ciupakt/caliper/README.md

# Caliper — bezprzewodowy system pomiarowy (ESP32 + suwmiarka)

Projekt **Caliper** to zaawansowany system bezprzewodowego pomiaru długości oparty na platformie ESP32, cyfrowej suwmiarce (odczyt strumienia bitów), akcelerometrze IIS328DQ oraz sterowniku silnika STSPIN250. Dane są przesyłane dwukierunkowo przez protokół **ESP-NOW**, a sterowanie odbywa się przez:

- **Web UI** hostowane przez ESP32 Master (WiFi AP + HTTP + LittleFS)
- **Desktop GUI** w Pythonie (Dear PyGui) komunikujące się z Master po **Serial**
- **Serial CLI** - interfejs wiersza poleceń przez port szeregowy
- **RC (Pilot)** - bezprzewodowy pilot z dwoma przyciskami (ESP-NOW → Master)

## 📑 Spis treści

- [Funkcjonalności](#funkcjonalności)
- [Architektura systemu](#architektura-systemu)
- [Wymagania](#wymagania)
- [Szybki start](#szybki-start)
- [Instalacja i konfiguracja](#instalacja-i-konfiguracja)
- [Użytkowanie](#użytkowanie)
- [Dokumentacja API](#dokumentacja-api)
- [Struktura projektu](#struktura-projektu)
- [Konfiguracja](#konfiguracja)
- [Rozwiązywanie problemów](#rozwiązywanie-problemów)
- [Współpraca](#współpraca)
- [Licencja](#licencja)

## ✨ Funkcjonalności

### Pomiar i sensory
- **Pomiar z cyfrowej suwmiarki** - dekodowanie danych z interfejsu CLK/DATA/TRIG
- **Walidacja zakresów** - automatyczna walidacja pomiarów (-1000.0 do 1000.0 mm)
- **Odczyt kąta z IIS328DQ** - akcelerometr I2C do pomiaru pochylenia
- **Pomiar napięcia baterii** - monitorowanie stanu baterii przez ADC

### Sterowanie silnikiem
- **Sterowanie silnikiem DC** przez sterownik STSPIN250
- **PWM + PH + REF + EN + FAULT** - pełna kontrola 5-pinowa z detekcją błędów
- **Automatyzacja pomiarów** - silnik uruchamiany automatycznie przy pomiarze

### Komunikacja
- **ESP-NOW** - dwukierunkowa komunikacja bezprzewodowa Master↔Slave
- **ESP-NOW RC→Master** - pilot RC wysyła komendy TRIG_MEAS / DROP_MEAS
- **HTTP API** - REST API dla Web UI
- **Serial CLI** - interfejs wiersza poleceń dla diagnostyki i konfiguracji
- **Retry mechanism** - automatyczne ponawianie wysyłek przy błędach

### Interfejsy użytkownika
- **Web UI** - responsywny interfejs HTML/CSS/JS hostowany na ESP32
- **Python GUI** - aplikacja desktopowa z Dear PyGui
  - Wykresy pomiarów w czasie rzeczywistym
  - Eksport danych do CSV
  - Logi systemowe
  - Kalibracja i konfiguracja

### Przechowywanie danych
- **Persistent Storage** - ustawienia zapisywane w NVS (Preferences)
- **Nazwy sesji pomiarowych** - organizacja pomiarów
- **Offset kalibracji** - trwałe przechowywanie wartości kalibracji
- **MeasurementState** - klasa zarządzająca stanem pomiarowym z buforami tekstowymi
- **PreferencesManager** - menedżer ustawień z walidacją i trwałym przechowywaniem

### System obsługi błędów
- **Kompleksowy system kodów błędów** - 8 kategorii (Communication, Sensor, Motor, Power, Storage, Network, Validation, System)
- **Makra logowania** - LOG_ERROR, LOG_WARNING z automatycznym dekodowaniem kategorii i modułu
- **ErrorHandler** - singleton do śledzenia statystyk błędów
- **Funkcje pomocnicze ESP-NOW** - espnow_send_with_retry, espnow_add_peer_with_retry

## 🏗️ Architektura systemu

### Komponenty systemu

```mermaid
flowchart TD
    %% Master pracuje równolegle: WiFi AP/HTTP + ESP-NOW, najczęściej WIFI_AP_STA.

    subgraph SYS[System Caliper]
        subgraph M[ESP32 Master<br/>caliper_master]
            M_HTTP[HTTP server :80]
            M_FS[LittleFS<br/>UI web: index.html/style.css/app.js]
            M_ESPNOW[ESP-NOW manager<br/>TX/RX MessageMaster/MessageSlave]
            M_SERIAL[Serial CLI<br/>komendy ASCII -> msgMaster]
            M_PREFS[Preferences Manager<br/>NVS storage]
            M_STATE[MeasurementState<br/>stan pomiarowy]
            M_ERROR[ErrorHandler<br/>statystyki błędów]
        end

        subgraph S[ESP32 Slave<br/>caliper_slave]
            S_ESPNOW[ESP-NOW<br/>RX komend / TX danych]
            S_CAL[Suwmiarka<br/>odczyt i dekoder]
            S_ACC[IIS328DQ<br/>I2C]
            S_BATT[Bateria<br/>ADC]
            S_MOTOR[Silnik<br/>STSPIN250]
        end

        subgraph SHARED[CaliperShared]
            SH_ERROR[ErrorCodes<br/>8 kategorii]
            SH_HELPER[ESP-NOW Helper<br/>retry mechanism]
        end

        subgraph RC[ESP32-C3 RC<br/>caliper_rc]
            RC_ESPNOW[ESP-NOW<br/>TX MessageRC]
            RC_BTN1[Przycisk TRIG<br/>GPIO8]
            RC_BTN2[Przycisk DROP<br/>GPIO9]
            RC_LED[LED<br/>feedback]
        end

        WEB[Przeglądarka<br/>Web UI]
        GUI[Python GUI<br/>Dear PyGui]
    end

    WEB <--> |HTTP| M_HTTP
    M_HTTP --> M_FS
    GUI <--> |USB Serial| M_SERIAL

    M_ESPNOW <--> |ESP-NOW| S_ESPNOW
    RC_ESPNOW --> |ESP-NOW<br/>CMD_TRIG_MEAS / CMD_DROP_MEAS| M_ESPNOW
    RC_BTN1 --> RC_ESPNOW
    RC_BTN2 --> RC_ESPNOW
    RC_ESPNOW --> RC_LED
    S_CAL --> S_ESPNOW
    S_ACC --> S_ESPNOW
    S_BATT --> S_ESPNOW
    S_MOTOR <--> S_ESPNOW

    M_SERIAL --> M_STATE
    M_PREFS --> M_STATE
    M_HTTP --> M_STATE
    M_ESPNOW --> M_STATE
    M_ERROR --> M_STATE
    
    M_ESPNOW -.-> |używa| SH_HELPER
    M_ERROR -.-> |używa| SH_ERROR
    S_ESPNOW -.-> |używa| SH_HELPER
```

### Przepływ pomiaru (typowy)

```mermaid
sequenceDiagram
    participant U as Użytkownik
    participant GUI as GUI przez Serial
    participant WEB as Web UI przez HTTP
    participant RC as RC Pilot
    participant M as ESP32 Master
    participant EH as ErrorHandler
    participant MS as MeasurementState
    participant PM as PreferencesManager
    participant S as ESP32 Slave
    participant CAL as Suwmiarka
    participant ACC as IIS328DQ
    participant BAT as Bateria

    alt Sterowanie z GUI
        U->>GUI: „Pomiar" (m)
        GUI->>M: Serial: m + LF
    else Sterowanie z Web UI
        U->>WEB: klik „Wykonaj pomiar"
        WEB->>M: HTTP /measure albo /measure_session
    else Sterowanie z RC
        U->>RC: przycisk TRIG_MEAS
        RC->>M: ESP-NOW: MessageRC{CMD_TRIG_MEAS}
    end

    M->>PM: loadSettings()
    PM-->>M: systemStatus (offset, motorSpeed, etc.)
    
    M->>MS: setMeasurementInProgress(true)
    M->>S: ESP-NOW: MessageMaster{CMD_MEASURE,...}
    
    alt Błąd ESP-NOW
        S-->>M: ESP-NOW: błąd
        M->>EH: recordError(ERR_ESPNOW_SEND_FAILED)
        EH->>M: LOG_ERROR
        M->>MS: setMeasurementInProgress(false)
    else Sukces
        S->>CAL: odczyt danych CLK/DATA + dekodowanie
        S->>ACC: odczyt kąta przez I2C
        S->>BAT: ADC read
        S-->>M: ESP-NOW: MessageSlave{measurement, angleZ, batteryVoltage}
        
        M->>MS: setMeasurement(measurement + offset)
        M->>MS: setReady(true)
        M->>MS: setMeasurementInProgress(false)
        
        M-->>GUI: Serial log/plot, wartości i offset
        M-->>WEB: JSON, raw i corrected
    end
```

### Połączenia hardware

```mermaid
flowchart LR
    %% Układ: urządzenia po lewej, ESP32 po środku, obciążenia po prawej.

    subgraph CAL[Cyfrowa suwmiarka]
        CAL_CLK[CLK]
        CAL_DATA[DATA]
        CAL_TRIG[TRIG]
    end

    subgraph ACC[IIS328DQ]
        ACC_I2C[I2C]
    end

    subgraph BATT[Bateria]
        BATT_V[Vbat]
    end

subgraph SL[ESP32 Slave]
         GPIO11[GPIO11<br/>CALIPER_CLOCK]
         GPIO12[GPIO12<br/>CALIPER_DATA]
         GPIO13[GPIO13<br/>CALIPER_TRIG]

         GPIO21[GPIO21<br/>I2C SDA]
         GPIO22[GPIO22<br/>I2C SCL]

         GPIO10[GPIO10<br/>BATTERY_ADC]

         GPIO6[GPIO6<br/>MOTOR_PWM]
         GPIO15[GPIO15<br/>MOTOR_PH]
         GPIO7[GPIO7<br/>MOTOR_REF]
         GPIO16[GPIO16<br/>MOTOR_EN]
         GPIO17[GPIO17<br/>MOTOR_FAULT]
     end

     subgraph DRV[STSPIN250]
         DRV_PWM[PWM]
         DRV_PH[PH]
         DRV_REF[REF]
         DRV_EN[EN]
         DRV_FAULT[FAULT]
         DRV_OUT1[OUT1]
         DRV_OUT2[OUT2]
     end

     subgraph MOT[Silnik DC]
         MOT_A[Motor +]
         MOT_B[Motor -]
     end

     CAL_CLK -->|CLK| GPIO11
     CAL_DATA -->|DATA| GPIO12
     GPIO13 -->|TRIG| CAL_TRIG

     GPIO21 <--> |SDA| ACC_I2C
     GPIO22 <--> |SCL| ACC_I2C

     BATT_V -->|ADC| GPIO10

     GPIO6 -->|PWM| DRV_PWM
     GPIO15 -->|PH| DRV_PH
     GPIO7 -->|REF| DRV_REF
     GPIO16 -->|EN| DRV_EN
     GPIO17 -->|FAULT| DRV_FAULT
     DRV_OUT1 --> MOT_A
     DRV_OUT2 --> MOT_B
```

## 📋 Wymagania

### Wymagania sprzętowe
- **1× ESP32-S3 DevKitC** — Slave (suwmiarka + akcelerometr + silnik)
- **1× ESP32-C3 Super Mini** — Master (AP WiFi + HTTP + ESP-NOW)
- **1× ESP32-C3 Super Mini** — RC Pilot (bezprzewodowy pilot)
   - Mikrokontroler: ESP32-C3 160MHz, 320KB RAM, 4MB Flash
- **Cyfrowa suwmiarka** z interfejsem CLK/DATA/TRIG
- **Akcelerometr IIS328DQ** (I2C)
- **Sterownik silnika STSPIN250**
- **Silnik DC**
- **Bateria** z obwodem pomiaru napięcia
- **Kable połączeniowe** zgodnie z diagramem hardware

### Wymagania programowe
- **PlatformIO** - do kompilacji firmware ESP32
   - Ścieżka do skryptów (Windows): `C:\Users\tiim\.platformio\penv\Scripts`
   - Alternatywnie: `pio` w PATH (po instalacji `pip install platformio`)
- **Python 3.x** - do uruchomienia GUI
- **Visual Studio Code** (zalecane) z rozszerzeniem PlatformIO

#### Kompilacja na Linux/macOS
```bash
# Slave
cd caliper_slave
pio run --environment caliper_slave

# Master
cd ../caliper_master
pio run --environment caliper_master

# RC
cd ../caliper_rc
pio run --environment caliper_rc
```

#### Wgrywanie firmware na Linux/macOS
```bash
# Slave (port np. /dev/ttyUSB0)
cd caliper_slave
pio run --target upload --environment caliper_slave --upload-port /dev/ttyUSB0

# Master (port np. /dev/ttyUSB0)
cd ../caliper_master
pio run --target upload --environment caliper_master --upload-port /dev/ttyUSB0

# RC (port np. /dev/ttyUSB0)
cd ../caliper_rc
pio run --target upload --environment caliper_rc --upload-port /dev/ttyUSB0
```

#### Wgrywanie Web UI (LittleFS)
```bash
# Linux/macOS
cd caliper_master
pio run --target uploadfs --environment caliper_master --upload-port /dev/ttyUSB0
```

### Zależności Python
Zobacz [`caliper_master_gui/requirements.txt`](caliper_master_gui/requirements.txt:1):
```
dearpygui>=1.9.0
pyserial>=3.5
```

## 🚀 Szybki start

### 1. Klonowanie repozytorium
```bash
git clone <repository-url>
cd caliper
```

### 2. Instalacja zależności Python
```powershell
cd caliper_master_gui
python -m pip install -r requirements.txt
```

### 3. Kompilacja firmware
```powershell
# Slave
cd caliper_slave
C:\Users\tiim\.platformio\penv\Scripts\platformio.exe run --environment caliper_slave

# Master
cd ..\caliper_master
C:\Users\tiim\.platformio\penv\Scripts\platformio.exe run --environment caliper_master

# RC (pilot)
cd ..\caliper_rc
C:\Users\tiim\.platformio\penv\Scripts\platformio.exe run --environment caliper_rc
```

### 4. Wgrywanie firmware
```powershell
# Slave (COM8)
cd caliper_slave
C:\Users\tiim\.platformio\penv\Scripts\platformio.exe run --target upload -s --environment caliper_slave --upload-port COM8

# Master (COM7)
cd ..\caliper_master
C:\Users\tiim\.platformio\penv\Scripts\platformio.exe run --target upload -s --environment caliper_master --upload-port COM7

# RC (COM9)
cd ..\caliper_rc
C:\Users\tiim\.platformio\penv\Scripts\platformio.exe run --target upload -s --environment caliper_rc --upload-port COM9
```

### 5. Wgrywanie Web UI (LittleFS)
```powershell
cd caliper_master
C:\Users\tiim\.platformio\penv\Scripts\platformio.exe run --target uploadfs -s --environment caliper_master --upload-port COM7
```

### 6. Uruchomienie GUI```powershell
cd caliper_master_gui
python caliper_master_gui.py
```

### 7. Użycie Web UI
1. Połącz się z WiFi: `TKK_DBMS` (hasło: `1670$2026`)
2. Otwórz w przeglądarce: `http://192.168.4.1`

## ⚙️ Instalacja i konfiguracja

### Instalacja PlatformIO

#### Windows
1. Zainstaluj [Visual Studio Code](https://code.visualstudio.com/)
2. Zainstaluj rozszerzenie [PlatformIO](https://marketplace.visualstudio.com/items?itemName=platformio.platformio-ide)
3. Alternatywnie: zainstaluj PlatformIO CLI:
   ```powershell
   pip install platformio
   ```

### Konfiguracja portów COM

Domyślne porty są zdefiniowane w plikach `platformio.ini`:
- **Master**: `COM7` ([`caliper_master/platformio.ini`](caliper_master/platformio.ini:1))
- **Slave**: `COM8` ([`caliper_slave/platformio.ini`](caliper_slave/platformio.ini:1))

Aby zmienić port, dodaj `--upload-port COMx` do komendy upload.

### Konfiguracja adresów MAC

Adresy MAC są zdefiniowane w plikach konfiguracyjnych:

**Master** ([`caliper_master/src/config.h`](caliper_master/src/config.h:28)):
```cpp
#define SLAVE_MAC_ADDR {0x10, 0xB4, 0x1D, 0xD6, 0x40, 0xAC}
#define RC_MAC_ADDR {0x00, 0x00, 0x00, 0x00, 0x00, 0x00}  // Uzupełnij po odczycie z RC
```

**Slave** ([`caliper_slave/src/config.h`](caliper_slave/src/config.h:29)):
```cpp
#define MASTER_MAC_ADDR {0x0C, 0x4E, 0xA0, 0x6F, 0x66, 0xD0}
```

**RC** ([`caliper_rc/src/config.h`](caliper_rc/src/config.h)):
```cpp
#define MASTER_MAC_ADDR {0x10, 0xB4, 0x1D, 0xD6, 0x40, 0xBB}
```

Aby znaleźć adres MAC urządzenia, uruchom firmware i sprawdź wyjście Serial przy starcie.

### Konfiguracja WiFi

WiFi AP jest konfigurowane w [`caliper_master/src/config.h`](caliper_master/src/config.h:35):
```cpp
#define WIFI_SSID "TKK_DBMS"
#define WIFI_PASSWORD "1670$2026"
#define WIFI_AP_IP IPAddress(192, 168, 4, 1)
```

## 📖 Użytkowanie

### Web UI

#### Menu główne
1. **Kalibracja** - ustawianie offsetu kalibracji
2. **Nowa sesja pomiarowa** - tworzenie nowej sesji

#### Kalibracja
1. Wprowadź referencję (Reference, mm: -999.999..999.999) — pole automatycznie synchronizuje referencję z urządzeniem
2. Kliknij "Calibrate" — wykonuje pomiar i ustawia offset = surowy pomiar (corrected = reference)
3. Wynik pokazuje: Raw, Offset (applied), Reference, Corrected

#### Sesja pomiarowa
1. Utwórz sesję przez podanie nazwy
2. Kliknij "Wykonaj pomiar" - wykona pomiar z uruchomieniem silnika
3. Wynik pokaże:
   - Pomiar skorygowany (raw - offset)
   - Pomiar surowy
   - Offset
   - Napięcie baterii
   - Odchylenie od pionu (angleZ)

### Python GUI

#### Zakładka "Pomiary"
- **Wykres** - wizualizacja pomiarów w czasie rzeczywistym
- **Historia** - lista ostatnich pomiarów
- **Eksport CSV** - zapis pomiarów do pliku
- **Hotkey 'p'** - szybkie wykonanie pomiaru

#### Zakładka "Kalibracja"
- **Offset kalibracji** - ustawianie i wyświetlanie offsetu
- **Konfiguracja silnika** - prędkość, moment, stan, timeout
- **Logi aplikacji** - komunikaty systemowe
- **Logi szeregowe** - komunikacja z Masterem

### Serial CLI

Podłącz Master przez USB Serial i użyj terminala (np. PuTTY, Arduino Serial Monitor) z ustawieniami:
- Baud rate: 115200
- Data bits: 8
- Parity: None
- Stop bits: 1

#### Dostępne komendy

| Komenda | Opis |
|---|---|
| `m` | Wykonaj pomiar |
| `u` | Zaktualizuj status |
| `t` | Test silnika |
| `o <wartość>` | Ustaw offset kalibracji (-999.999..999.999) |
| `q <wartość>` | Ustaw timeout (ms, 0..600000) |
| `s <wartość>` | Ustaw prędkość silnika (0..255) |
| `r <wartość>` | Ustaw moment silnika (0..255) |
| `n <nazwa>` | Ustaw nazwę sesji (maks 31 znaków) |
| `h` | Pomoc |
| `d` | Wyświetl stan systemu |

### RC Pilot (caliper_rc)

Pilot bezprzewodowy z dwoma przyciskami komunikujący się z Masterem przez ESP-NOW.

#### Przyciski
| Przycisk | Pin | Komenda ESP-NOW | Efekt |
|---|-----|---|---|
| TRIG | GPIO8 | `CMD_TRIG_MEAS` ('R') | Wyzwala pomiar (jak komenda "m") |
| DROP | GPIO9 | `CMD_DROP_MEAS` ('D') | Usuwa ostatni pomiar z GUI + CSV |

#### Komunikacja
- RC → Master: struktura `MessageRC` (1 pole: `CommandType command`)
- Master rozpoznaje pakiety RC po rozmiarze `sizeof(MessageRC)` vs `sizeof(MessageSlave)`
- LED na płytce miga krótko przy wysłaniu komendy (100 ms)

#### Konfiguracja
1. Odczytaj MAC adres RC z Serial output przy starcie
2. Wpisz MAC do `RC_MAC_ADDR` w [`caliper_master/src/config.h`](caliper_master/src/config.h)
3. Wpisz MAC Mastera do `MASTER_MAC_ADDR` w [`caliper_rc/src/config.h`](caliper_rc/src/config.h)
4. Skompiluj i wgraj oba firmware

## 🔌 Dokumentacja API

### HTTP API

#### Endpointy pomiaru

**POST /measure**
Wyzwala pojedynczy pomiar.
```http
POST /measure HTTP/1.1
```
**Odpowiedź:**
```
Pomiar wyzwolony
```

**POST /measure_session**
Wyzwala pomiar w ramach aktywnej sesji.
```http
POST /measure_session HTTP/1.1
```
**Odpowiedź (JSON):**
```json
{
  "sessionName": "moja_sesja",
  "measurementRaw": 12.345,
  "calibrationOffset": 0.000,
  "measurementCorrected": 12.345,
  "valid": true,
  "batteryVoltage": 3.7,
  "angleZ": 5
}
```

#### Endpointy kalibracji

**POST /api/calibration/measure**
Wykonuje pomiar i zwraca surową wartość.
```http
POST /api/calibration/measure HTTP/1.1
```
**Odpowiedź (JSON):**
```json
{
  "success": true,
  "measurementRaw": 12.345,
  "calibrationOffset": 0.000
}
```

**POST /api/calibration/offset**
Ustawia offset kalibracji.
```http
POST /api/calibration/offset?offset=1.234 HTTP/1.1
```
**Odpowiedź (JSON):**
```json
{
  "success": true,
  "calibrationOffset": 1.234
}
```

**POST /api/calibrate**
Jednorazowa kalibracja atomowa (jak przycisk "Calibrate" w GUI): ustawia referencję, wykonuje pomiar i ustawia `calibrationOffset = surowy pomiar`. `corrected` jest liczone ze **starego** offsetu (przed kalibracją) — jak etykieta `Calibration:` w GUI przed wysłaniem komendy `c`.
```http
POST /api/calibrate?reference=10.000 HTTP/1.1
```
**Odpowiedź (JSON):**
```json
{
  "success": true,
  "reference": 10.000,
  "corrected": 9.931
}
```
> Uwaga: jak pozostałe endpointy kalibracji Web, offset/referencja zapisywane są tylko w RAM (nie w NVS) — giną po restarcie Mastera.

#### Endpointy sesji

**POST /start_session**
Rozpoczyna nową sesję pomiarową.
```http
POST /start_session?sessionName=moja_sesja HTTP/1.1
```
**Odpowiedź (JSON):**
```json
{
  "sessionName": "moja_sesja"
}
```

### Serial Protocol

Master wysyła dane przez Serial w formacie `DEBUG_PLOT`:
```
>measurement:12.345
>dropMeas:1
>calibrationOffset:0.000
>angleZ:5
>batteryVoltage:3.700
>timeout:1000
>motorSpeed:100
>motorTorque:100
>motorState:0
>sessionName:moja_sesja
```

**Klucz `dropMeas:1`** — wysyłany gdy RC naciska przycisk DROP_MEAS. GUI usuwa ostatni pomiar z historii, wykresu i pliku CSV.

## 📁 Struktura projektu

```
caliper/
├── caliper_master/              # Firmware Master ESP32
│   ├── src/
│   │   ├── main.cpp             # Główna logika: AP WiFi + HTTP + ESP-NOW + LittleFS
│   │   ├── config.h             # Konfiguracja specyficzna dla Master
│   │   ├── communication.h/.cpp # Menedżer komunikacji ESP-NOW
│   │   ├── serial_cli.h/.cpp    # Interfejs wiersza poleceń
│   │   ├── measurement_state.h/.cpp # Zarządzanie stanem pomiarowym
│   │   └── preferences_manager.h/.cpp # Przechowywanie ustawień w NVS
│   ├── data/                    # Pliki LittleFS (HTML/CSS/JS)
│   │   ├── index.html
│   │   ├── style.css
│   │   └── app.js
│   └── platformio.ini
│
├── caliper_slave/               # Firmware Slave ESP32
│   ├── src/
│   │   ├── main.cpp             # Główna logika: ESP-NOW + harmonogram
│   │   ├── config.h             # Konfiguracja specyficzna dla Slave
│   │   ├── sensors/
│   │   │   ├── caliper.h/.cpp   # Obsługa suwmiarki
│   │   │   └── accelerometer.h/.cpp # Obsługa IIS328DQ
│   │   ├── motor/
│   │   │   └── motor_ctrl.h/.cpp # Sterowanie silnikiem
│   │   └── power/
│   │       └── battery.h/.cpp   # Pomiar napięcia baterii
│   └── platformio.ini
│
├── caliper_rc/                  # Firmware RC Pilot (ESP32-C3)
│   ├── src/
│   │   ├── main.cpp             # Główna logika: przyciski + ESP-NOW
│   │   ├── config.h             # Konfiguracja RC (piny, MAC)
│   │   └── communication.h/.cpp # Menedżer komunikacji ESP-NOW (MessageRC)
│   └── platformio.ini
│
├── caliper_master_gui/          # Aplikacja GUI Python
│   ├── caliper_master_gui.py    # Entry-point GUI (Dear PyGui)
│   ├── requirements.txt
│   ├── INSTALL_UBUNTU.md        # Instrukcja instalacji na Ubuntu
│   ├── src/
│   │   ├── __init__.py
│   │   ├── serial_handler.py    # Obsługa portu szeregowego
│   │   ├── utils/
│   │   │   └── csv_handler.py   # Obsługa CSV
│   │   └── gui/
│   │       ├── calibration_tab.py # Zakładka kalibracji
│   │       └── measurement_tab.py # Zakładka pomiarów
│   └── tests/
│       └── test_serial.py       # Testy jednostkowe
│
├── lib/CaliperShared/           # Współdzielona biblioteka
│   ├── shared_common.h          # Wspólne definicje typów/struktur (MessageMaster, MessageSlave, MessageRC, CommandType)
│   ├── shared_config.h          # Wspólna konfiguracja (piny, stałe)
│   ├── MacroDebugger.h          # Makra debug/log/plot
│   ├── error_codes.h/.cpp       # System kodów błędów (8 kategorii)
│   ├── error_handler.h          # Makra logowania błędów i klasa ErrorHandler
│   └── espnow_helper.h/.cpp     # Funkcje pomocnicze ESP-NOW z retry
│
├── doc/                         # Dokumentacja sprzętowa
│   ├── ESP32-DevKit-V1-Pinout-Diagram-r0.1-CIRCUITSTATE-Electronics-2-1280x896.png
│   ├── stspin250.pdf
│   └── schematic.png
│
├── AGENTS.md                    # Instrukcje dla AI
├── CHANGELOG.md                 # Historia zmian
├── CONTRIBUTING.md              # Współpraca z projektem
└── README.md                    # Ten plik
```

## ⚙️ Konfiguracja

### System obsługi błędów

System obsługi błędów zapewnia spójne zarządzanie błędami w całym projekcie. Kody błędów to 16-bitowe wartości, gdzie wysoki bajt oznacza kategorię (dla czytelności), a dekodowanie odbywa się przez switch — bez bit-packingu.

**Kategorie błędów (high byte):**
- `0x00XX` - Brak błędu
- `0x01XX` - Communication (ESP-NOW, Serial, WiFi)
- `0x02XX` - Sensor (suwmiarka, akcelerometr)
- `0x03XX` - Motor (sterownik silnika)
- `0x04XX` - Power (bateria, ADC)
- `0x05XX` - Storage (LittleFS, NVS/Preferences)
- `0x06XX` - Network (WiFi AP, Web Server)
- `0x07XX` - Validation (walidacja danych)
- `0x08XX` - System (błędy systemowe)

**Przykłady kodów błędów:**
- `ERR_ESPNOW_SEND_FAILED` (0x0102) - Wysłanie ESP-NOW nieudane
- `ERR_ACCEL_INIT_FAILED` (0x0205) - Inicjalizacja akcelerometru nieudana
- `ERR_PREFS_SAVE_FAILED` (0x0507) - Zapis Preferences nieudany

**Makra logowania:**
```cpp
RECORD_ERROR(errorCode, "Szczegóły...");  // zapis + LOG_ERROR
LOG_ERROR(errorCode, "Szczegóły...");
LOG_WARNING(errorCode, "Szczegóły...");
```

### Wspólna konfiguracja ([`lib/CaliperShared/shared_config.h`](lib/CaliperShared/shared_config.h:1))

#### ESP-NOW
```cpp
#define ESPNOW_WIFI_CHANNEL 1
#define ESPNOW_RETRY_DELAY_MS 100
#define ESPNOW_MAX_RETRIES 3
```

#### Piny
```cpp
// Suwmiarka
#define CALIPER_CLOCK_PIN 11
#define CALIPER_DATA_PIN 12
#define CALIPER_TRIG_PIN 13

// Silnik (STSPIN250)
#define MOTOR_PWM_PIN 6      // PWM input - speed control
#define MOTOR_PH_PIN 15      // Phase input - direction control
#define MOTOR_REF_PIN 7      // REF input - current limit
#define MOTOR_EN_PIN 16      // Enable pin - HIGH = enabled
#define MOTOR_FAULT_PIN 17   // Fault input - LOW = fault detected

// Bateria
#define BATTERY_VOLTAGE_PIN 10
```

#### Walidacja pomiarów
```cpp
#define MEASUREMENT_MIN_VALUE -1000.0f
#define MEASUREMENT_MAX_VALUE 1000.0f
#define INVALID_MEASUREMENT_VALUE -999.0f
```

### Klasa MeasurementState ([`caliper_master/src/measurement_state.h`](caliper_master/src/measurement_state.h:1))

Klasa zarządzająca stanem pomiarowym systemu:

```cpp
static MeasurementState measurementState;

// Ustawienie pomiaru
measurementState.setMeasurement(123.456f);

// Pobranie flagi gotowości
if (measurementState.isReady()) {
    float value = measurementState.getValue();
}

// Resetowanie flagi gotowości
measurementState.setReady(false);
```

### Klasa PreferencesManager ([`caliper_master/src/preferences_manager.h`](caliper_master/src/preferences_manager.h:1))

Menedżer ustawień z trwałym przechowywaniem w NVS:

```cpp
static PreferencesManager prefsManager;

// Inicjalizacja i wczytanie ustawień
prefsManager.begin();
prefsManager.loadSettings(&systemStatus);

// Zapisanie ustawienia
prefsManager.saveMotorSpeed(150);
prefsManager.saveCalibrationOffset(1.234f);

// Reset do wartości domyślnych
prefsManager.resetToDefaults();
```

**Zakresy wartości:**
- `motorSpeed`: 0-255 (domyślnie: 100)
- `motorTorque`: 0-255 (domyślnie: 100)
- `timeout`: 0-600000 ms (domyślnie: 1000)
- `calibrationOffset`: -999.999..999.999 mm (domyślnie: 0.0)

### Konfiguracja Master ([`caliper_master/src/config.h`](caliper_master/src/config.h:1))

#### WiFi
```cpp
#define WIFI_SSID "TKK_DBMS"
#define WIFI_PASSWORD "1670$2026"
#define WIFI_AP_IP IPAddress(192, 168, 4, 1)
```

#### Web Server
```cpp
#define WEB_SERVER_PORT 80
#define HTML_BUFFER_SIZE 2048
#define WEB_UPDATE_INTERVAL_MS 10
```

#### Ustawienia
```cpp
#define MAX_LOG_ENTRIES 200
```

### Konfiguracja Slave ([`caliper_slave/src/config.h`](caliper_slave/src/config.h:1))

#### Ustawienia
```cpp
#define ADC_SAMPLES 8
```

### Konfiguracja RC ([`caliper_rc/src/config.h`](caliper_rc/src/config.h:1))

#### Przyciski i LED
```cpp
#define BUTTON_TRIG_PIN 8   // Przycisk TRIG_MEAS
#define BUTTON_DROP_PIN 9   // Przycisk DROP_MEAS
#define DEBOUNCE_DELAY_MS 50
#define LED_PIN LED_GREEN   // LED4 na ESP32-C3 Super Mini
```

#### Struktura komunikacji RC
```cpp
// shared_common.h
struct MessageRC {
  CommandType command;  // CMD_TRIG_MEAS ('R') lub CMD_DROP_MEAS ('D')
};
```

## 🔧 Rozwiązywanie problemów

### Problemy z ESP-NOW

**Problem:** Master nie otrzymuje danych od Slave

**Rozwiązania:**
1. Sprawdź adresy MAC w plikach konfiguracyjnych
2. Upewnij się, że oba urządzenia są na tym samym kanale WiFi (kanał 1)
3. Sprawdź zasięg między urządzeniami
4. Uruchom ponownie oba urządzenia

**Problem:** Master nie reaguje na pilot RC

**Rozwiązania:**
1. Upewnij się, że `RC_MAC_ADDR` w `caliper_master/src/config.h` jest uzupełniony prawidłowym MAC adresem RC (nie placeholderem `{0x00,...}`)
2. Upewnij się, że `MASTER_MAC_ADDR` w `caliper_rc/src/config.h` jest uzupełniony MAC adresem Mastera
3. Sprawdź, że RC i Master są na tym samym kanale WiFi (kanał 1)
4. Odczytaj MAC RC z Serial output przy starcie urządzenia

### Problemy z kompilacją

**Problem:** Błędy kompilacji PlatformIO

**Rozwiązania:**
1. Wyczyść pliki kompilacji:
   ```powershell
   cd caliper_slave && C:\Users\tiim\.platformio\penv\Scripts\platformio.exe run --target clean --environment esp32doit-devkit-v1
   cd caliper_master && C:\Users\tiim\.platformio\penv\Scripts\platformio.exe run --target clean --environment esp32doit-devkit-v1
   ```
2. Zaktualizuj PlatformIO:
   ```powershell
   pio upgrade
   pio pkg update
   ```
3. Sprawdź, czy używasz poprawnego środowiska: `esp32doit-devkit-v1`

### Problemy z Web UI

**Problem:** Web UI nie ładuje się

**Rozwiązania:**
1. Upewnij się, że LittleFS został wgrany:
   ```powershell
   cd caliper_master
   C:\Users\tiim\.platformio\penv\Scripts\platformio.exe run --target uploadfs -s --environment esp32doit-devkit-v1 --upload-port COM7
   ```
2. Sprawdź połączenie z WiFi AP
3. Sprawdź adres IP: `http://192.168.4.1`

### Problemy z Python GUI

**Problem:** GUI nie łączy się z Masterem

**Rozwiązania:**
1. Sprawdź, czy Master jest podłączony przez USB
2. Wybierz poprawny port COM w GUI
3. Sprawdź, czy inne aplikacje nie używają portu
4. Upewnij się, że Master jest uruchomiony

### Problemy z suwmiarką

**Problem:** Odczyt suwmiarky zwraca nieprawidłowe wartości

**Rozwiązania:**
1. Sprawdź połączenia CLK, DATA, TRIG
2. Sprawdź zasilanie suwmiarki
3. Sprawdź, czy suwmiarka jest kompatybilna z protokołem
4. Uruchom debug mode i sprawdź logi

### Debugowanie

Aby włączyć szczegółowe logowanie, ustaw `DEBUG_ENABLED` na `true` w [`lib/CaliperShared/shared_config.h`](lib/CaliperShared/shared_config.h:64):
```cpp
#define DEBUG_ENABLED true
```

Logi są wysyłane przez Serial z prędkością 115200 baud.

## 🤝 Współpraca

Chcesz wnieść wkład w projekt? Zobacz [`CONTRIBUTING.md`](CONTRIBUTING.md:1) dla szczegółowych instrukcji.

### Proces rozwoju
1. Forknij repozytorium
2. Utwórz branch dla swojej zmiany
3. Wprowadź zmiany
4. Przetestuj
5. Wyślij Pull Request

### Zgłaszanie błędów
Użyj GitHub Issues z szablonem zgłoszenia błędu.

## 📄 Licencja

Projekt hobbystyczny/edukacyjny.

---

**Wersja:** 3.1
**Data aktualizacji:** 2026-05-04
**Platforma:** ESP32 DOIT DEVKIT V1 + ESP32-C3 Super Mini (RC)
