ciupakt/caliper/CHANGELOG.md

# Changelog

Wszystkie istotne zmiany w projekcie Caliper.
