ciupakt/caliper/doc/KRAB.pdf

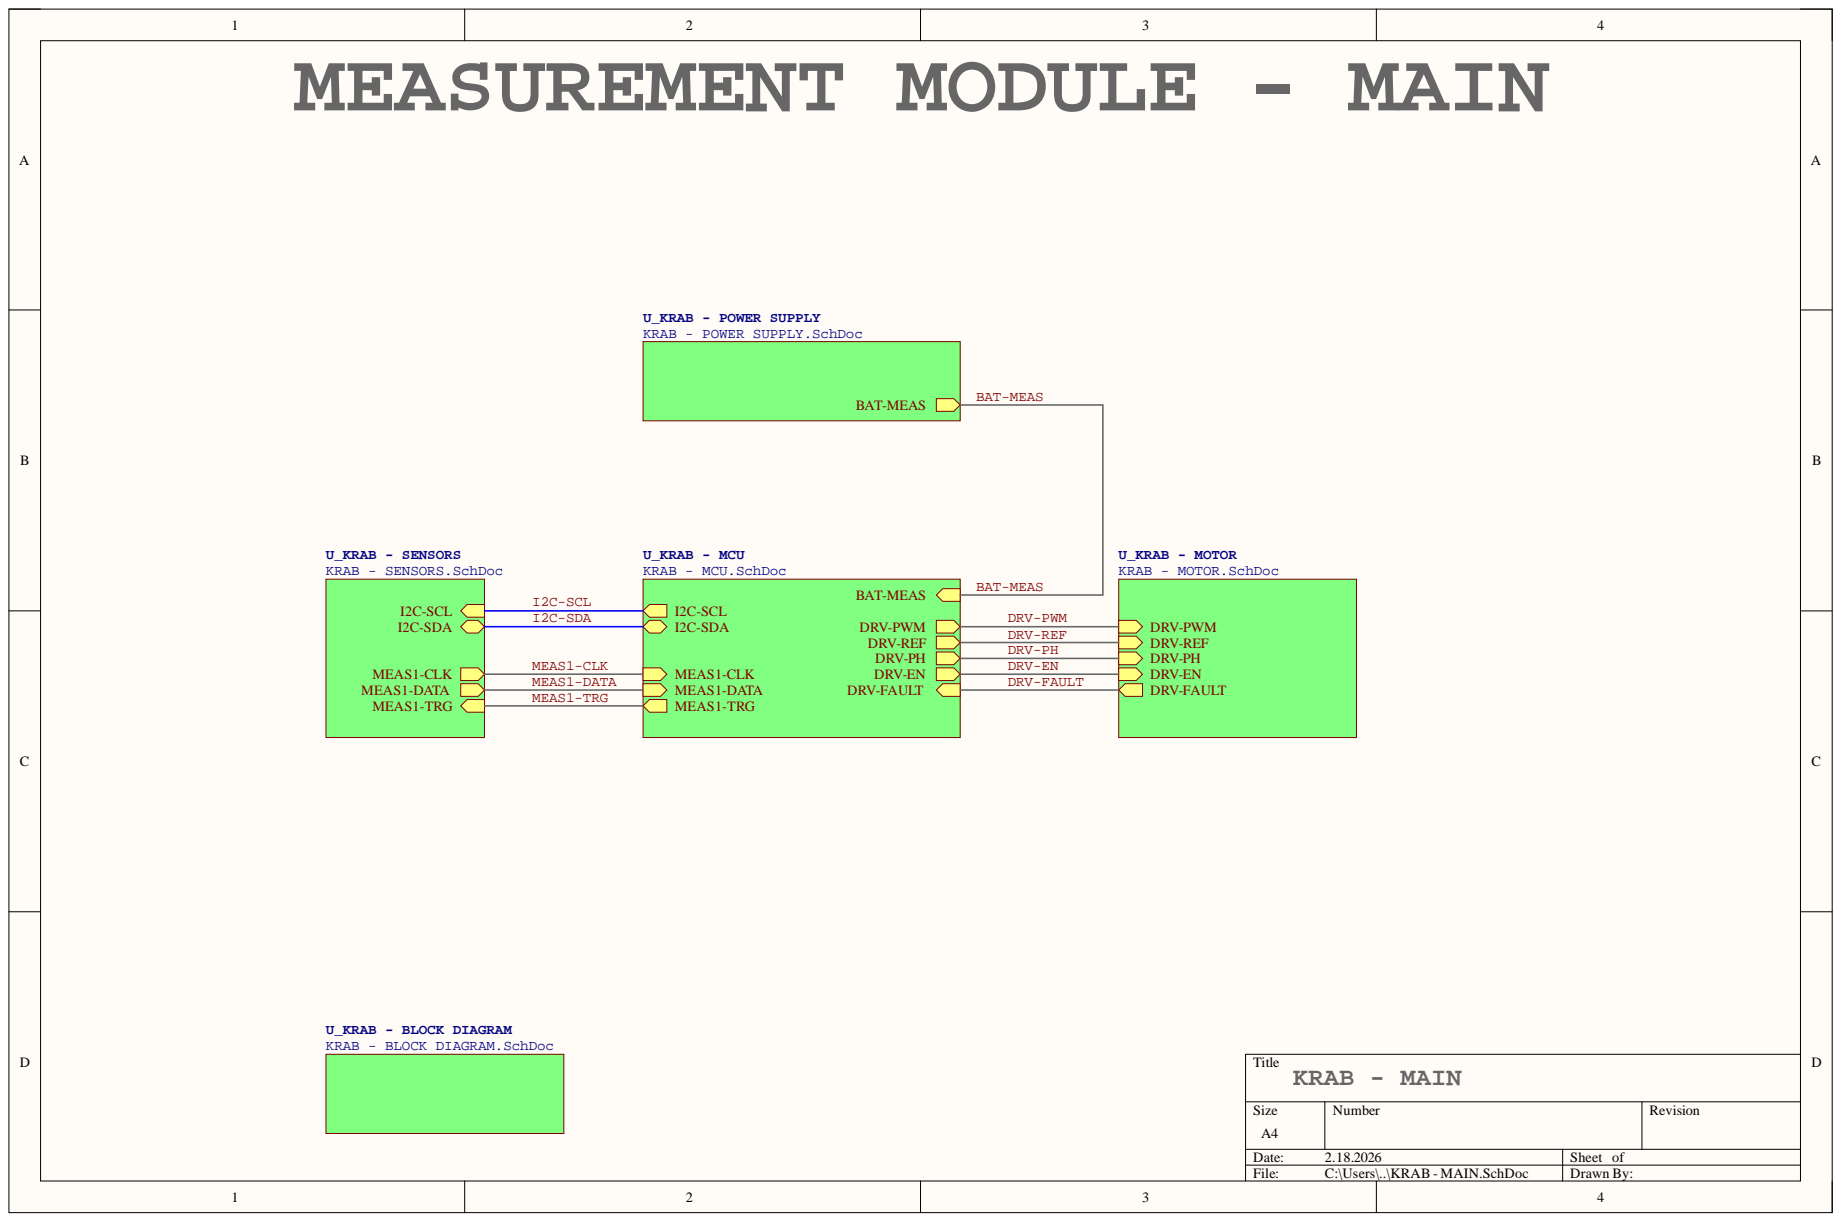
[picture p1: page 1]

U_KRAB - POWER SUPPLY
KRAB - POWER SUPPLY.SchDoc

U_KRAB - BLOCK DIAGRAM
KRAB - BLOCK DIAGRAM.SchDoc

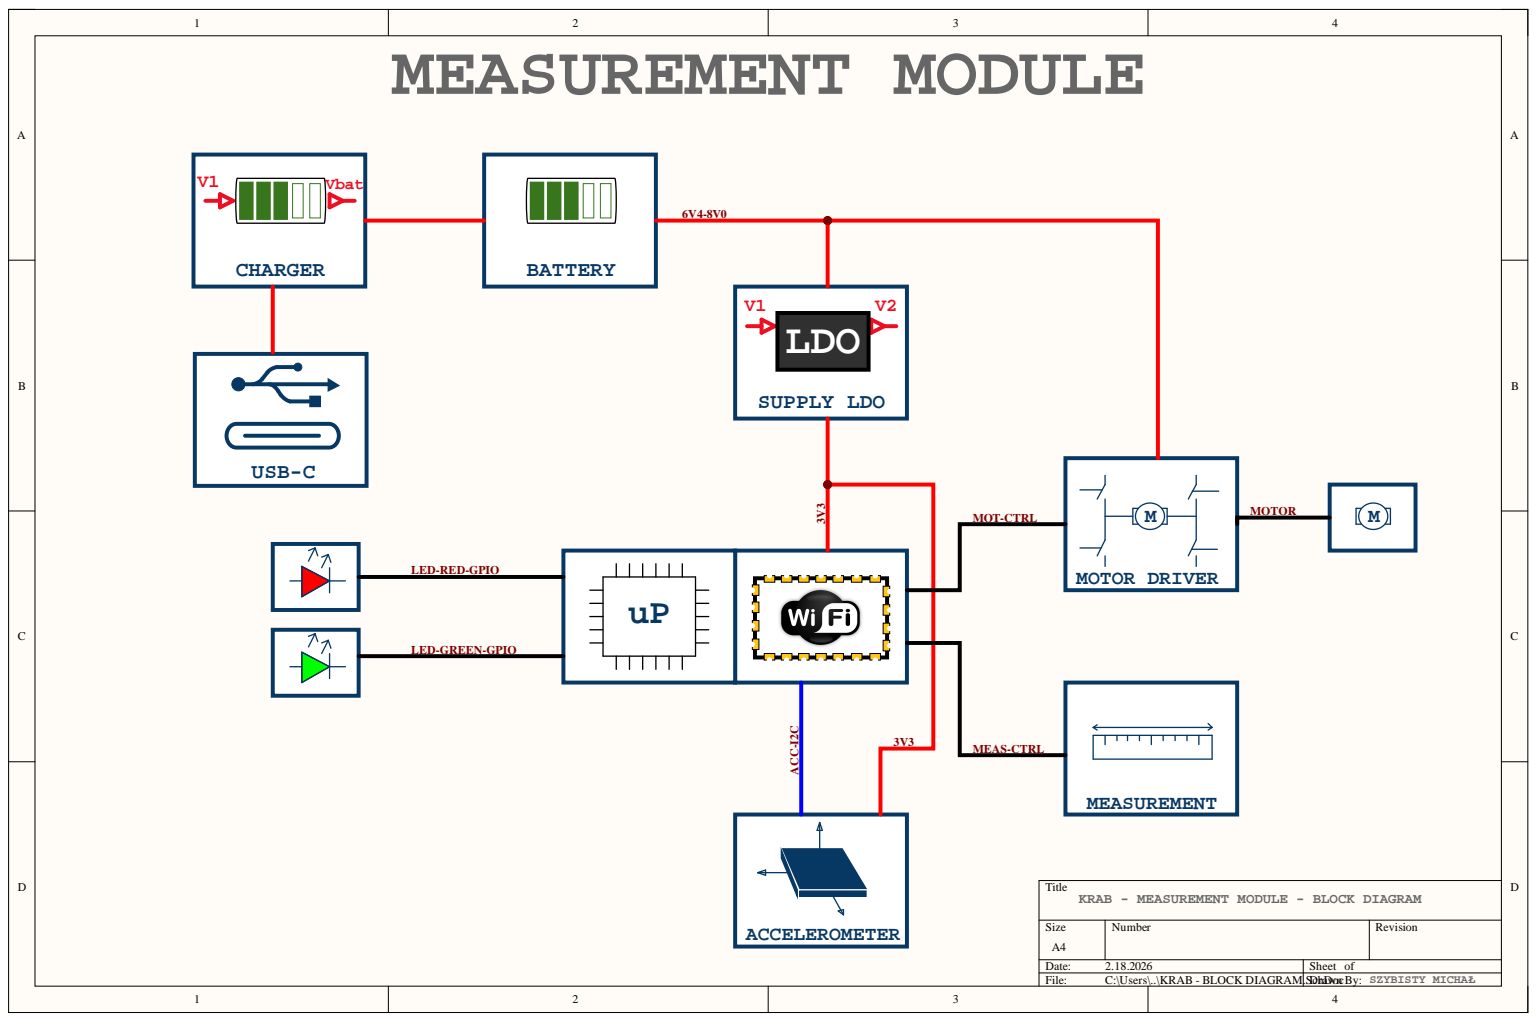
[picture p2: page 2]

Title
KRAB - MEASUREMENT MODULE - BLOCK DIAGRAM

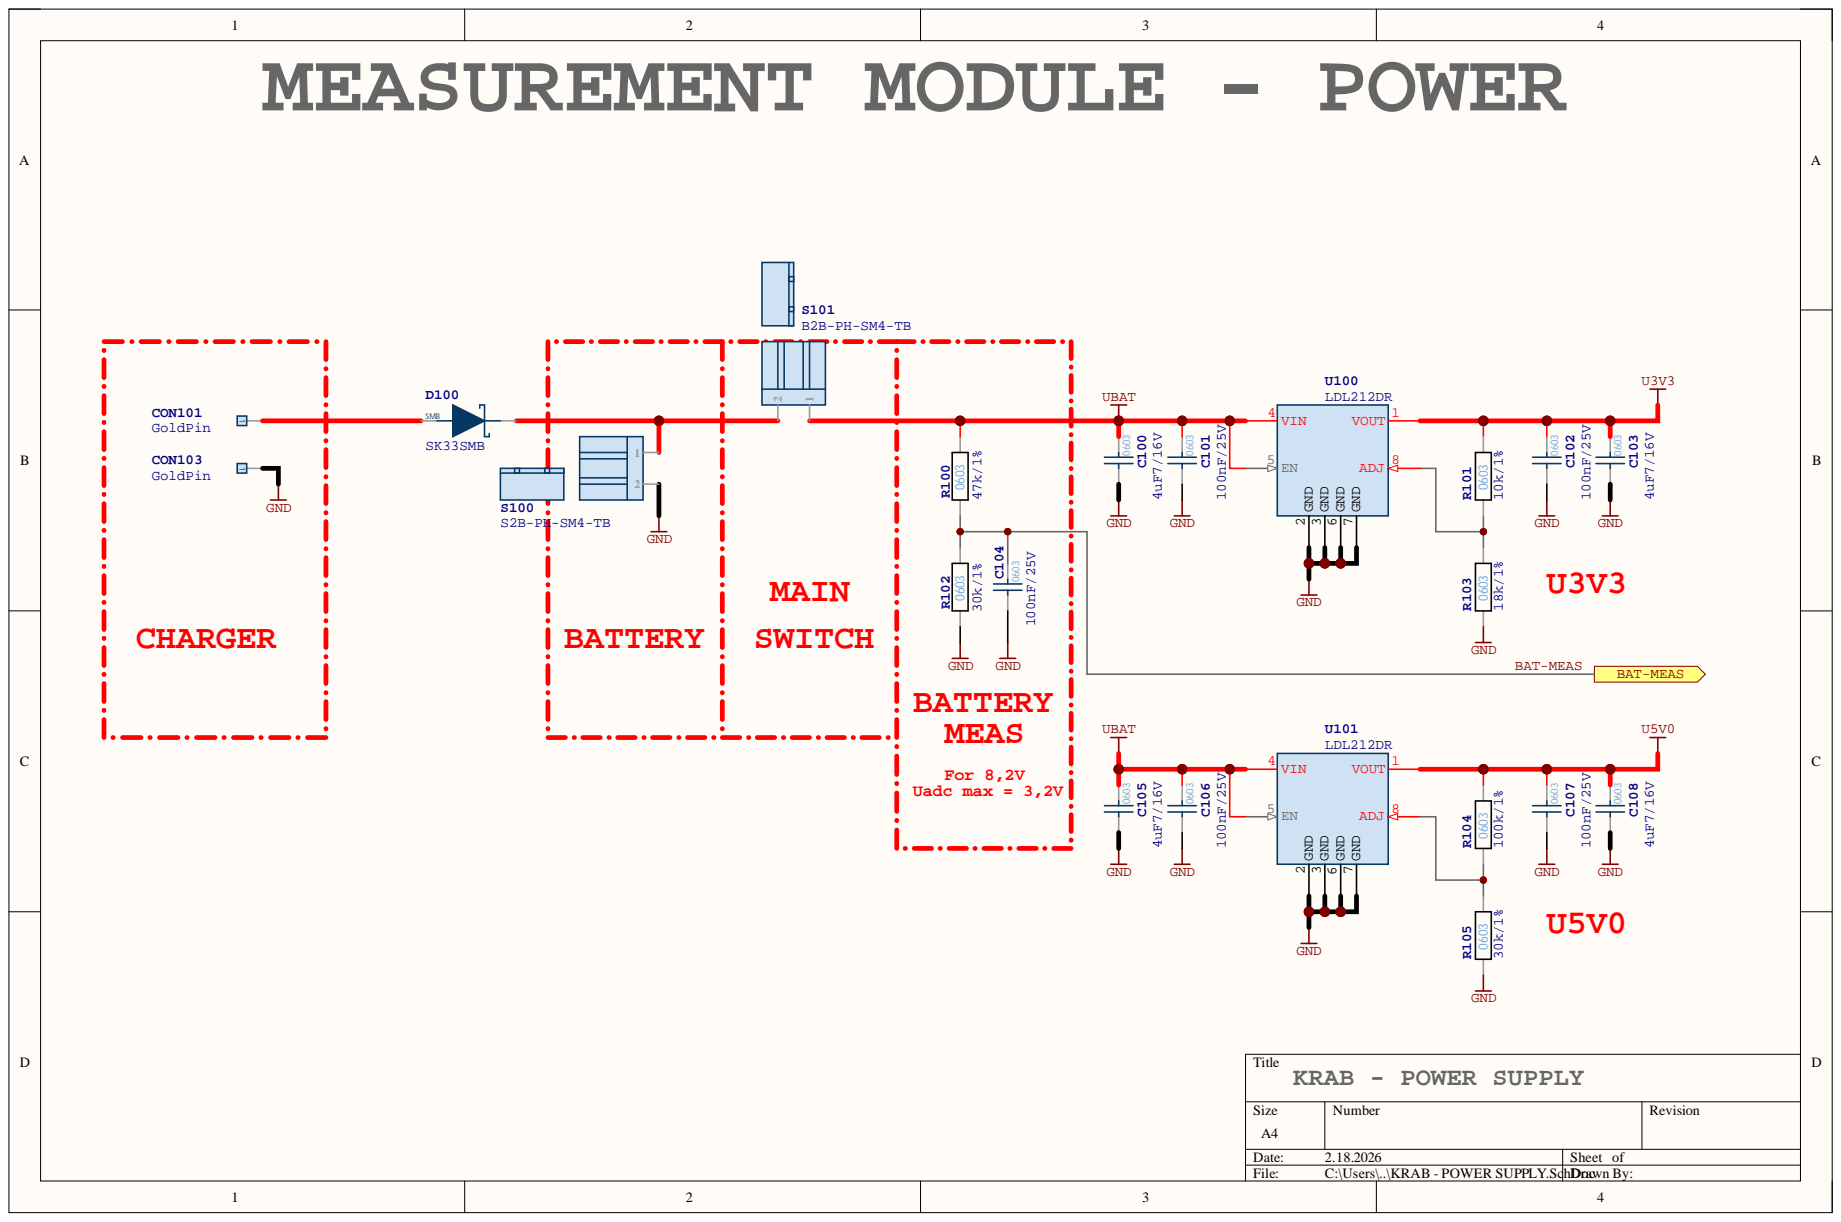
[picture p3: page 3]

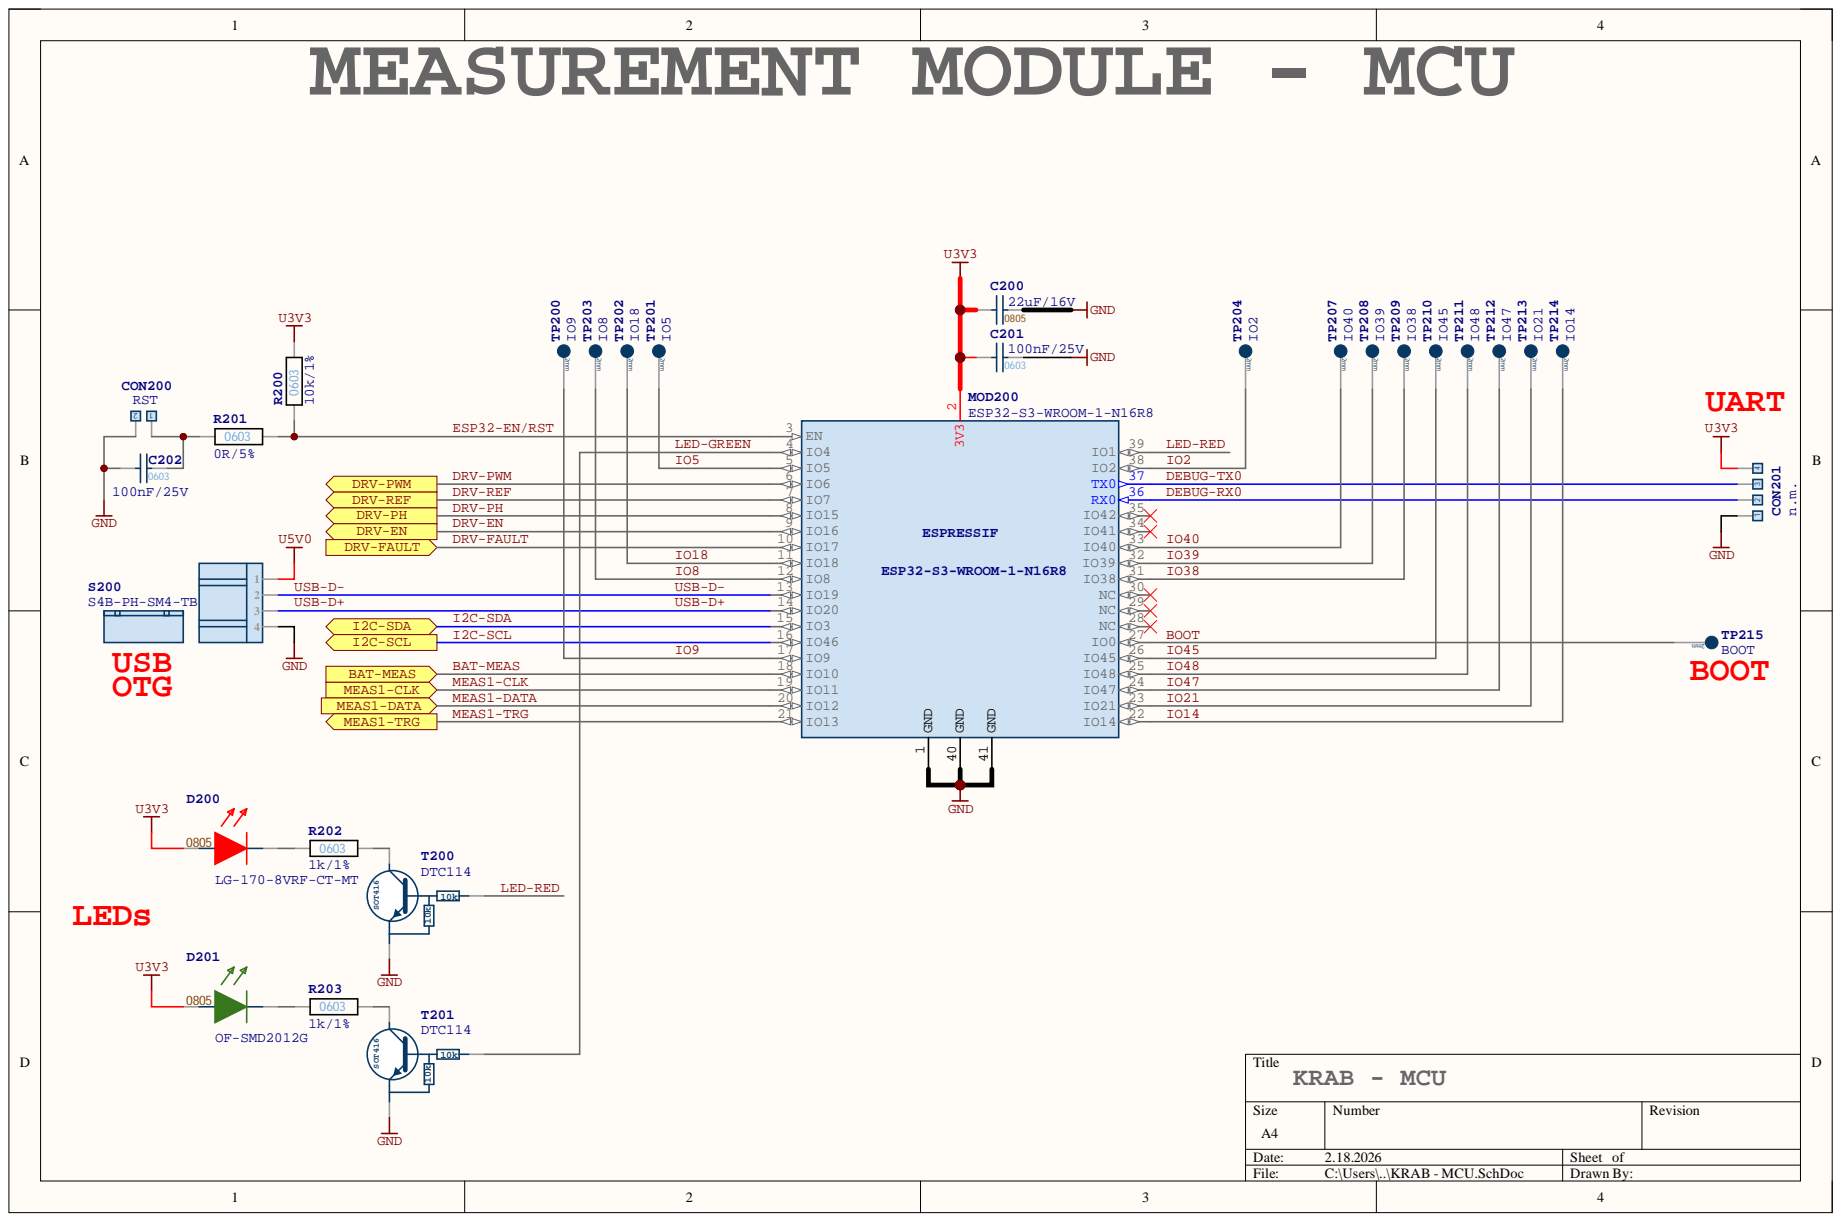
[picture p4: page 4]

LED-RED IO2
IO5

LED-GREEN

USB-D+ | USB-D+

I2C-SDA | | IO3 15

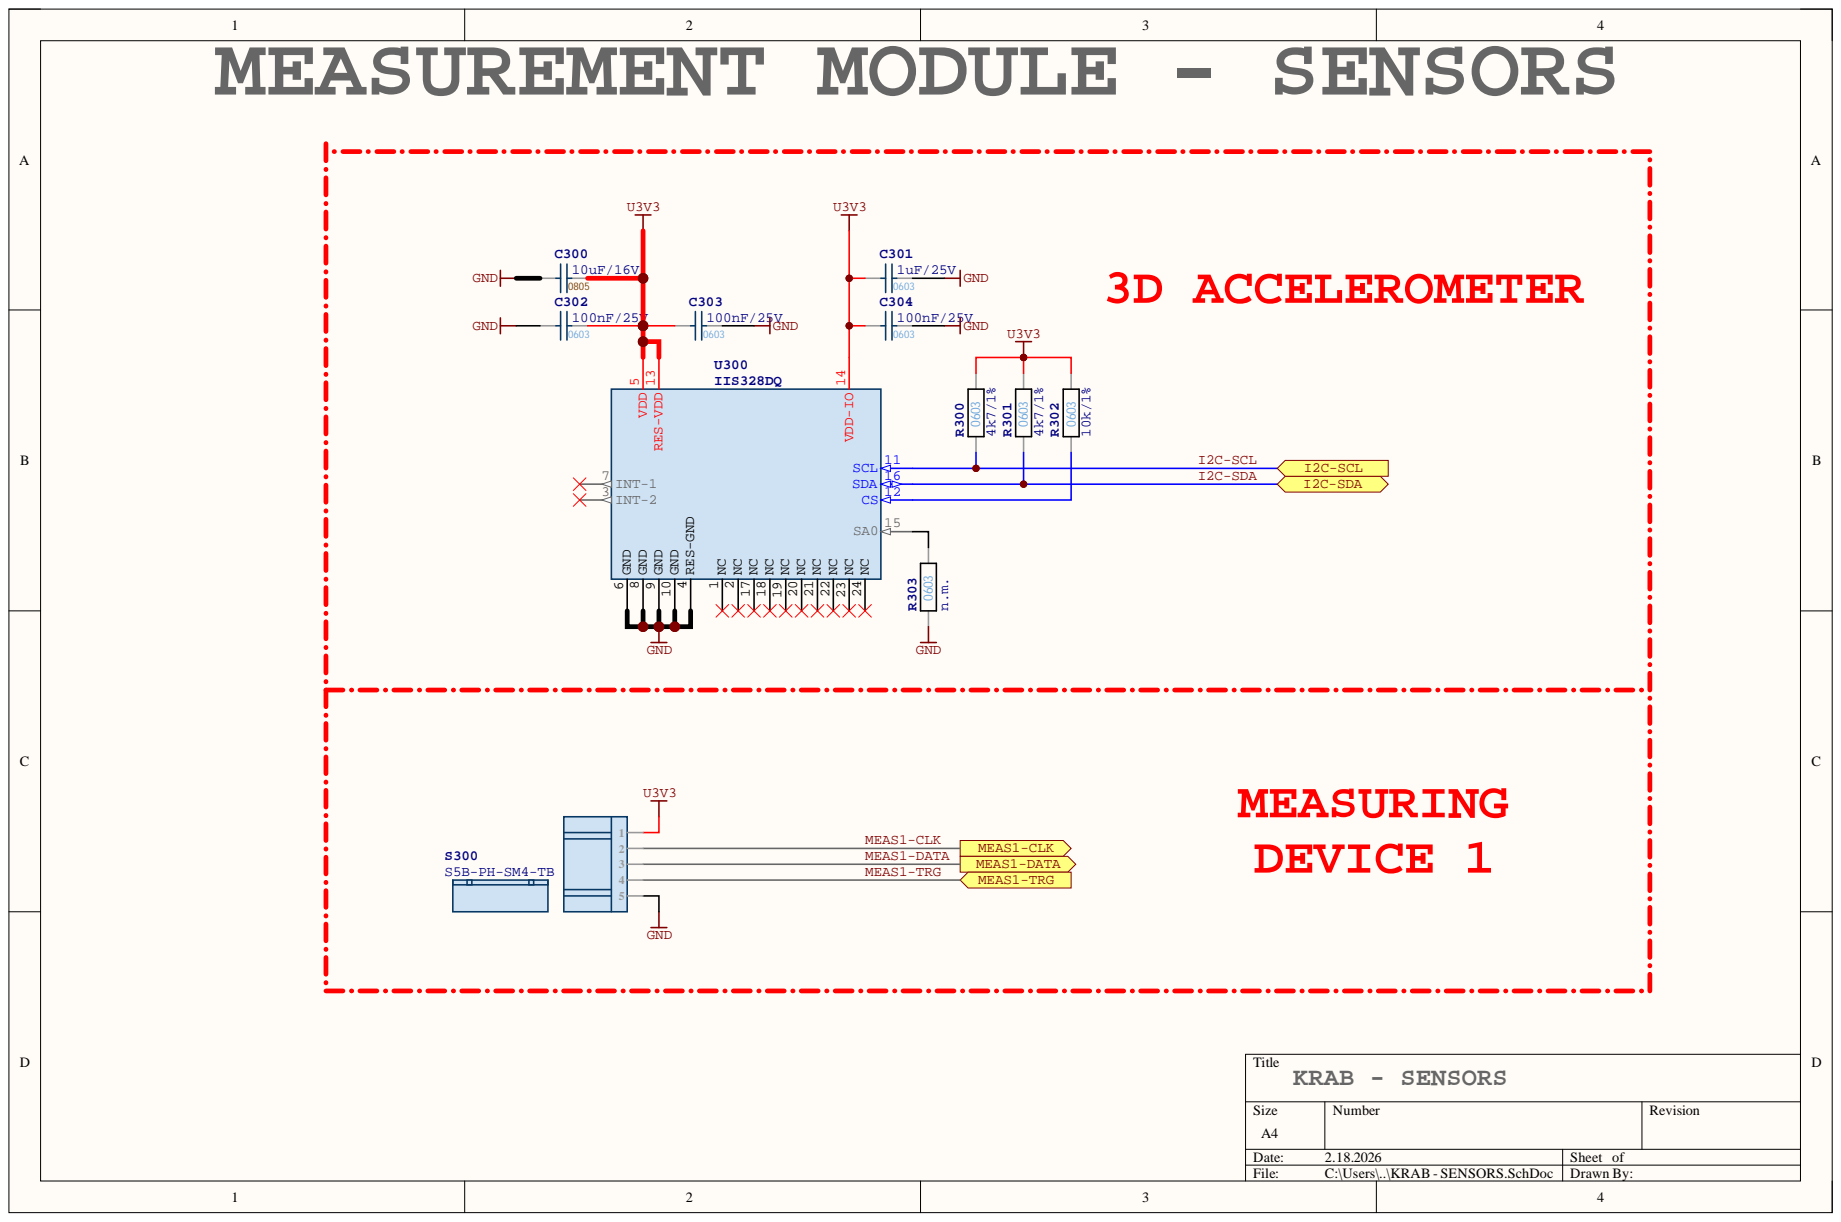
[picture p5: page 5]

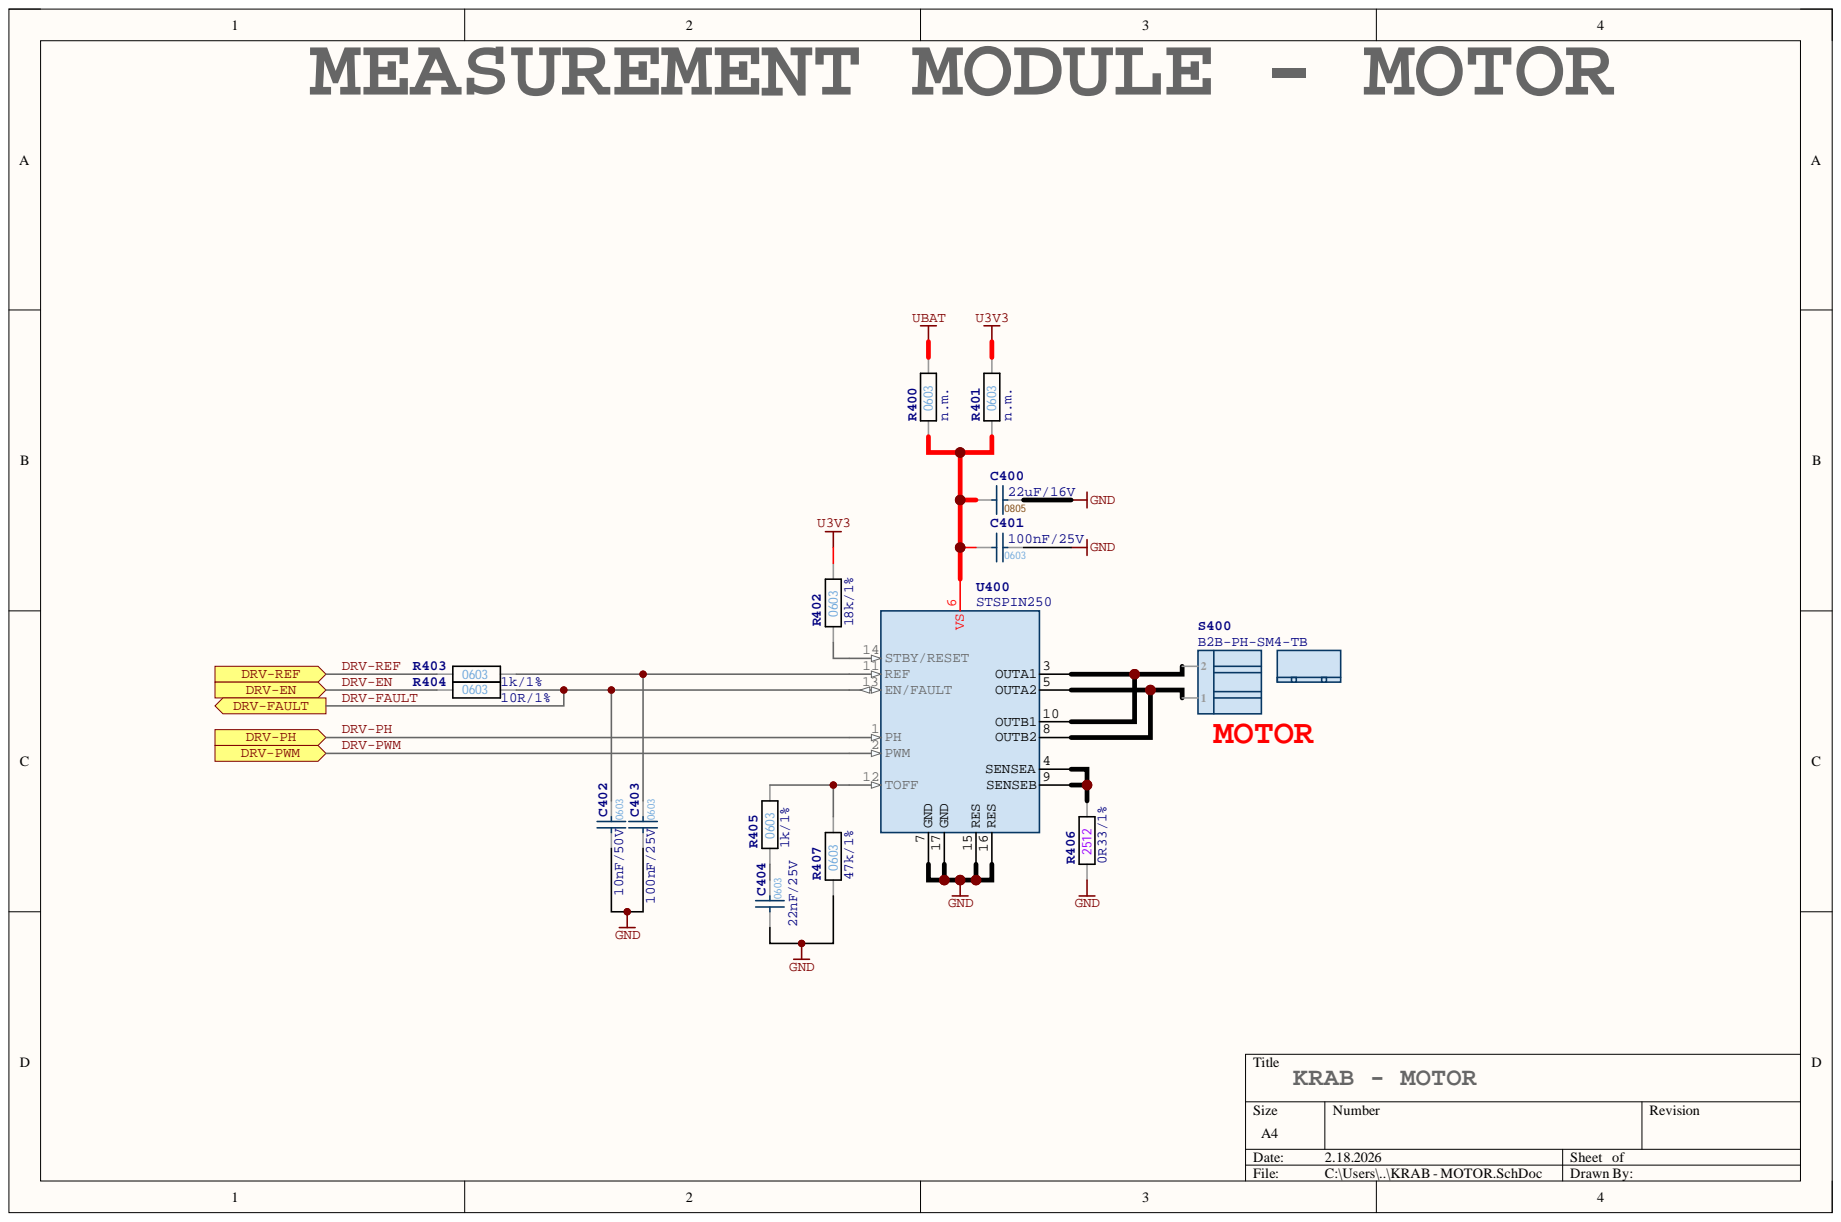
[picture p6: page 6]

MEASUREMENT MODULE - MOTOR VS 6

1k/1% | | EN/FAULT 13

TOFF 12

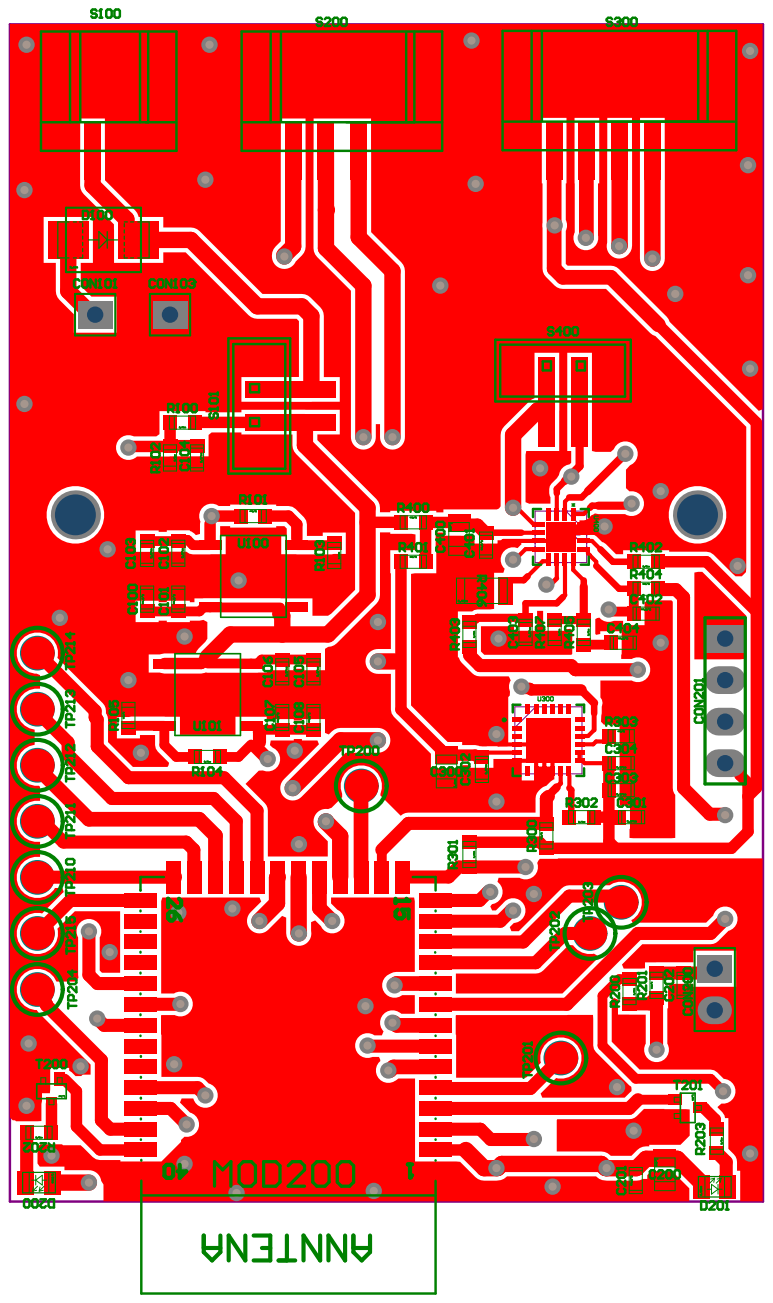
[picture p7: page 7]

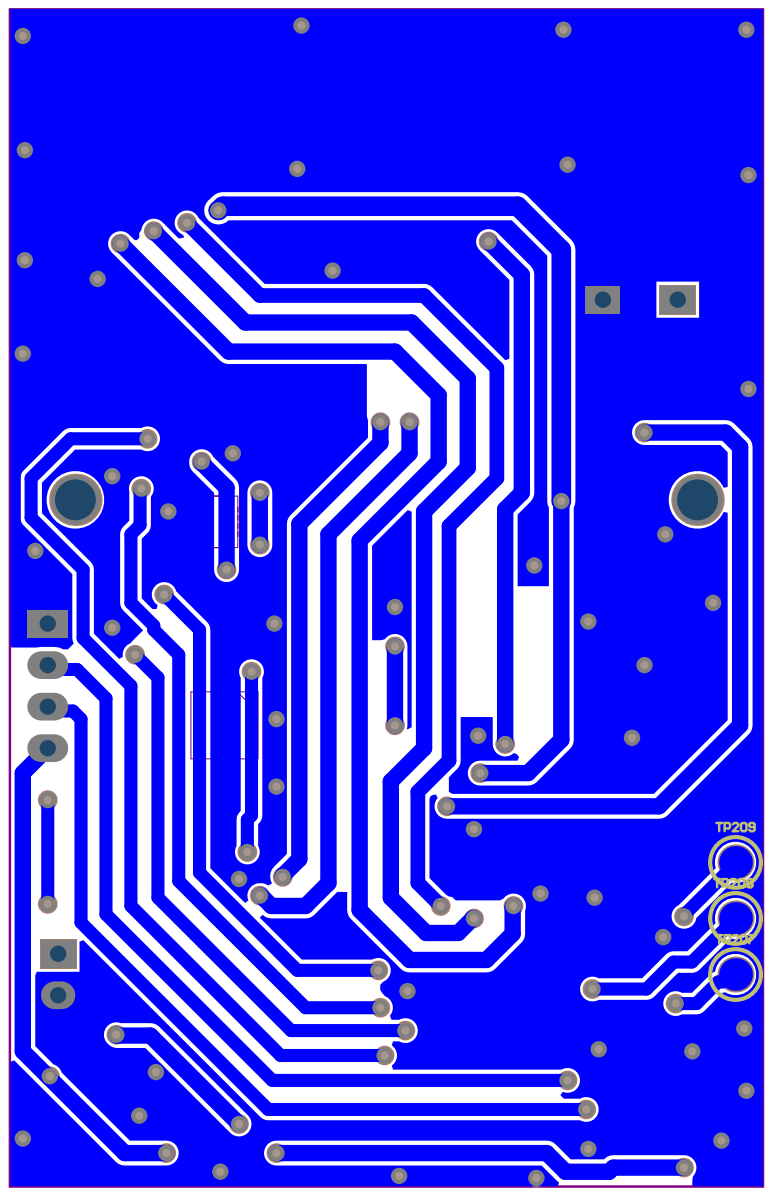
[picture p8: page 8]
