ciupakt/caliper/caliper_hw/esp32_slave.kicad_sch

## KiCad design caliper_hw/esp32_slave.kicad_sch (2025-11-11, an earlier design)

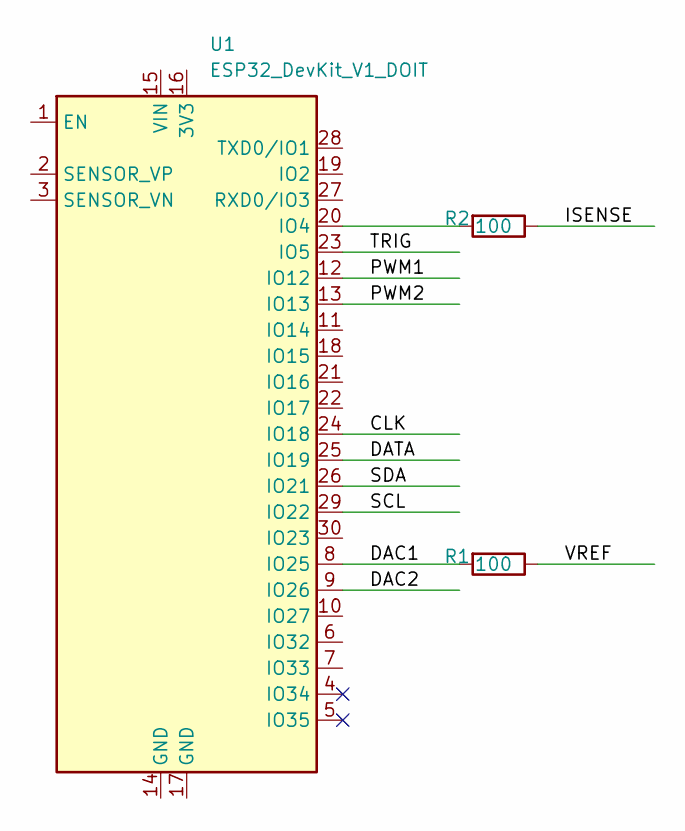
[picture p9: schematic esp32_slave.kicad_sch]

Parts:
R1, R2: 100
U1: ESP32_DevKit_V1_DOIT; esp32_devkit_v1_doit

Connections:
CLK: U1.24 (IO18)
DAC1: R1.2, U1.8 (IO25)
DAC2: U1.9 (IO26)
DATA: U1.25 (IO19)
ISENSE: R2.1
unnamed: R2.2, U1.20 (IO4)
PWM1: U1.12 (IO12)
PWM2: U1.13 (IO13)
SCL: U1.29 (IO22)
SDA: U1.26 (IO21)
TRIG: U1.23 (IO5)
VREF: R1.1
