ciupakt/caliper/caliper_rc/src/config.h

/**
 * @file config.h
 * @brief Configuration file for ESP32 Caliper RC
 * @date 2026-05-03
 * @version 1.0
 */

#ifndef CONFIG_RC_H
#define CONFIG_RC_H

#include <Arduino.h>

#include <shared_config.h>

// ============================================================================
// Button Pin Configuration (ESP32-C3 Super Mini)
// ============================================================================

#define BUTTON_TRIG_PIN 0
#define BUTTON_DROP_PIN 1
#define DEBOUNCE_DELAY_MS 50

// ============================================================================
// LED Indicator
// ============================================================================

#define LED_PIN 8

#endif // CONFIG_RC_H
