ciupakt/caliper/caliper_master/src/config.h

/**
 * @file config.h
 * @brief Configuration file for ESP32 Caliper Master
 * @author System Generated
 * @date 2025-12-26
 * @version 2.0
 * 
 * This file contains Master-specific configuration.
 * Common settings are inherited from shared/config_base.h
 */

#ifndef CONFIG_MASTER_H
#define CONFIG_MASTER_H

#include <Arduino.h>

// Include shared base configuration
#include <shared_config.h>

// ============================================================================
// Device MAC Address Configuration
// ============================================================================

/**
 * @brief MAC address of the Slave device
 * Default/fallback MAC — overridden by NVS if paired.
 * To find the MAC address, run the slave and check Serial output at startup.
 */
#define SLAVE_MAC_ADDR {0x10, 0xB4, 0x1D, 0xD6, 0x40, 0xAC}

/**
 * @brief MAC address of the RC device
 * Default/fallback MAC — overridden by NVS if paired.
 */
#define RC_MAC_ADDR {0x00, 0x00, 0x00, 0x00, 0x00, 0x00}

// ============================================================================
// WiFi Access Point Configuration
// ============================================================================
#define WIFI_SSID "TKK_DBMS"
#define WIFI_PASSWORD "1670$2026"
#define WIFI_AP_IP IPAddress(192, 168, 4, 1)

// ============================================================================
// Web Server Configuration
// ============================================================================
#define WEB_SERVER_PORT 80
#define HTML_BUFFER_SIZE 2048
#define WEB_UPDATE_INTERVAL_MS 10

// ============================================================================
// Master-specific Settings
// ============================================================================
#define MAX_LOG_ENTRIES 200

#endif // CONFIG_MASTER_H
