ciupakt/caliper/caliper_master/src/communication.cpp

/**
 * @file communication.cpp
 * @brief ESP-NOW Communication Module Implementation
 * @author System Generated
 * @date 2025-11-30
 * @version 2.1
 *
 * @version 2.0 - Integrated comprehensive error code system
 * @version 2.1 - Refactored to use shared espnow_send_with_retry function
 */

#include "communication.h"
#include <espnow_helper.h>

CommunicationManager::CommunicationManager() : initialized(false), lastError(ERR_NONE)
{
  // Initialize with default values
  memset(slaveAddress, 0, 6);
  memset(&peerInfo, 0, sizeof(peerInfo));
}

ErrorCode CommunicationManager::initialize(const uint8_t *slaveAddr)
{
  if (!slaveAddr)
  {
    RECORD_ERROR(ERR_VALIDATION_INVALID_PARAM, "Null slave address provided");
    lastError = ERR_VALIDATION_INVALID_PARAM;
    return lastError;
  }

  // Copy slave address
  memcpy(slaveAddress, slaveAddr, 6);

  // Initialize ESP-NOW
  if (esp_now_init() != ESP_OK)
  {
    RECORD_ERROR(ERR_ESPNOW_INIT_FAILED, "ESP-NOW initialization failed");
    lastError = ERR_ESPNOW_INIT_FAILED;
    return lastError;
  }

  // Configure peer info
  memcpy(peerInfo.peer_addr, slaveAddress, 6);
  peerInfo.channel = ESPNOW_WIFI_CHANNEL;
  peerInfo.encrypt = false;

  // Add peer
  if (esp_now_add_peer(&peerInfo) != ESP_OK)
  {
    RECORD_ERROR(ERR_ESPNOW_PEER_ADD_FAILED, "Failed to add peer: %02X:%02X:%02X:%02X:%02X:%02X",
      slaveAddress[0], slaveAddress[1], slaveAddress[2], slaveAddress[3], slaveAddress[4], slaveAddress[5]);
    lastError = ERR_ESPNOW_PEER_ADD_FAILED;
    return lastError;
  }

  DEBUG_I("Slave peer dodany: %02X:%02X:%02X:%02X:%02X:%02X",
    slaveAddress[0], slaveAddress[1], slaveAddress[2], slaveAddress[3], slaveAddress[4], slaveAddress[5]);

  initialized = true;
  lastError = ERR_NONE;
  return lastError;
}

ErrorCode CommunicationManager::sendMessage(const MessageMaster &message, int retryCount)
{
  if (!initialized)
  {
    RECORD_ERROR(ERR_ESPNOW_SEND_FAILED, "Communication manager not initialized");
    lastError = ERR_ESPNOW_SEND_FAILED;
    return lastError;
  }

  // Use shared retry function for consistent behavior
  ErrorCode result = espnow_send_with_retry(
      slaveAddress,
      &message,
      sizeof(message),
      retryCount,
      ESPNOW_RETRY_DELAY_MS
  );

  lastError = result;
  return result;
}

void CommunicationManager::setReceiveCallback(esp_now_recv_cb_t callback)
{
  if (initialized && callback)
  {
    esp_now_register_recv_cb(callback);
  }
}

void CommunicationManager::setSendCallback(esp_now_send_cb_t callback)
{
  if (initialized && callback)
  {
    esp_now_register_send_cb(callback);
  }
}

ErrorCode CommunicationManager::updatePeerAddress(const uint8_t *newAddr)
{
  if (!newAddr)
  {
    RECORD_ERROR(ERR_VALIDATION_INVALID_PARAM, "Null address provided for peer update");
    lastError = ERR_VALIDATION_INVALID_PARAM;
    return lastError;
  }

  esp_now_del_peer(slaveAddress);

  memcpy(slaveAddress, newAddr, 6);

  memset(&peerInfo, 0, sizeof(peerInfo));
  memcpy(peerInfo.peer_addr, slaveAddress, 6);
  peerInfo.channel = ESPNOW_WIFI_CHANNEL;
  peerInfo.encrypt = false;

  ErrorCode result = espnow_add_peer_with_retry(&peerInfo);
  if (result != ERR_NONE)
  {
    RECORD_ERROR(ERR_ESPNOW_PEER_ADD_FAILED, "Failed to update peer: %02X:%02X:%02X:%02X:%02X:%02X",
      slaveAddress[0], slaveAddress[1], slaveAddress[2], slaveAddress[3], slaveAddress[4], slaveAddress[5]);
    lastError = ERR_ESPNOW_PEER_ADD_FAILED;
    return lastError;
  }

  DEBUG_I("CommunicationManager: Updated slave peer to %02X:%02X:%02X:%02X:%02X:%02X",
    slaveAddress[0], slaveAddress[1], slaveAddress[2], slaveAddress[3], slaveAddress[4], slaveAddress[5]);
  lastError = ERR_NONE;
  return lastError;
}

ErrorCode CommunicationManager::addRcPeer(const uint8_t *rcAddr)
{
  if (!rcAddr)
  {
    RECORD_ERROR(ERR_VALIDATION_INVALID_PARAM, "Null RC address provided");
    lastError = ERR_VALIDATION_INVALID_PARAM;
    return lastError;
  }

  esp_now_peer_info_t rcPeerInfo{};
  memcpy(rcPeerInfo.peer_addr, rcAddr, 6);
  rcPeerInfo.channel = ESPNOW_WIFI_CHANNEL;
  rcPeerInfo.encrypt = false;

  esp_now_del_peer(rcAddr);

  ErrorCode result = espnow_add_peer_with_retry(&rcPeerInfo);
  if (result != ERR_NONE)
  {
    RECORD_ERROR(ERR_ESPNOW_PEER_ADD_FAILED, "Failed to add RC peer: %02X:%02X:%02X:%02X:%02X:%02X",
      rcAddr[0], rcAddr[1], rcAddr[2], rcAddr[3], rcAddr[4], rcAddr[5]);
    lastError = ERR_ESPNOW_PEER_ADD_FAILED;
    return lastError;
  }

  DEBUG_I("CommunicationManager: Added RC peer: %02X:%02X:%02X:%02X:%02X:%02X",
    rcAddr[0], rcAddr[1], rcAddr[2], rcAddr[3], rcAddr[4], rcAddr[5]);
  lastError = ERR_NONE;
  return lastError;
}

void CommunicationManager::removeRcPeer()
{
  // RC peer is not tracked in this class; caller manages it via esp_now directly
}
