ciupakt/caliper/caliper_master_gui/src/gui/measurement_tab.py

"""caliper_master_gui.src.gui.measurement_tab

"Measurements" tab (GUI).
"""

import dearpygui.dearpygui as dpg
from collections import deque
from datetime import datetime
import threading
import re
import os
import subprocess
import sys

_APP_TITLE = "TKK DBMS 1.0"


class MeasurementTab:
    """Measurement tab component for displaying measurements and controls"""

    def __init__(self, max_history: int = 1000, max_plot_points: int = 500):
        self.max_history = max_history
        self.max_plot_points = max_plot_points
        self.meas_history = deque(maxlen=max_history)
        self.plot_x = deque(maxlen=max_plot_points)
        self.plot_y = deque(maxlen=max_plot_points)
        self.measurement_count = 0
        # Must match the default_value=True of the checkboxes below;
        # _show_measurements() reads these flags, not the checkbox widgets.
        self.include_timestamp = True
        self.include_angle = True

        self.calibration_offset: float = 0.0
        self.reference: float = 0.0

        # Default CSV file prefix (replacement for "measurement_")
        self.csv_prefix: str = "test"

        # Session name (used as default value in input field)
        self.session_name: str = ""

        # References set in create()
        self._csv_handler = None
        self._on_drop = None

    def create(self, parent: int, serial_handler, csv_handler, on_drop=None, on_calibrate=None, on_reference_changed=None):
        """Create the measurement tab UI

        Args:
            on_drop: optional callback invoked after canceling last
                     measurement (e.g. to sync Gauge tab).
            on_calibrate: optional callback invoked by the toolbar
                     "Calibration" button (same as Settings "Get raw value").
            on_reference_changed: optional callback invoked when the user
                     edits the Reference field; receives the new float value.
        """
        self._csv_handler = csv_handler
        self._on_drop = on_drop
        self._on_calibrate = on_calibrate
        self._on_reference_changed = on_reference_changed
        with dpg.tab(label="Measurements", parent=parent):
            # --- Top toolbar: Reference + Calibration (2x font) ---
            with dpg.group(horizontal=True, tag="meas_toolbar_row"):
                ref_lbl = dpg.add_text("Reference (mm)")
                if dpg.does_item_exist("font_x2"):
                    dpg.bind_item_font(ref_lbl, "font_x2")

                ref_input = dpg.add_input_float(
                    tag="ref_input_meas",
                    default_value=0.0,
                    min_value=-999.999,
                    max_value=999.999,
                    format="%.3f",
                    width=150,
                    step=0,
                    step_fast=0,
                    callback=self._on_ref_input_changed,
                )
                if dpg.does_item_exist("font_x2"):
                    dpg.bind_item_font(ref_input, "font_x2")

                # Flexible spacer pushing Calibration to the right edge.
                dpg.add_spacer(width=10, tag="meas_toolbar_spacer")

                cal_lbl = dpg.add_text(
                    "Calibration: n/a",
                    tag="calibration_label",
                    color=(255, 255, 255, 255),
                )
                if dpg.does_item_exist("font_x2"):
                    dpg.bind_item_font(cal_lbl, "font_x2")

                calib_btn = dpg.add_button(
                    label="Calibrate",
                    tag="calibrate_btn",
                    callback=self._on_calibrate_btn,
                    width=200,
                    height=45,
                )
                if dpg.does_item_exist("font_bold"):
                    dpg.bind_item_font(calib_btn, "font_bold")

                # Disabled-state theme: clearly grays out the button when
                # calibration is unavailable (e.g. right after a new session,
                # until the Reference field is edited).
                if not dpg.does_item_exist("calibrate_btn_theme"):
                    with dpg.theme(tag="calibrate_btn_theme"):
                        with dpg.theme_component(dpg.mvButton, enabled_state=False):
                            dpg.add_theme_color(dpg.mvThemeCol_Text, (140, 140, 140, 255))
                            dpg.add_theme_color(dpg.mvThemeCol_Button, (55, 55, 55, 255))
                            dpg.add_theme_color(dpg.mvThemeCol_ButtonHovered, (55, 55, 55, 255))
                            dpg.add_theme_color(dpg.mvThemeCol_ButtonActive, (55, 55, 55, 255))
                dpg.bind_item_theme(calib_btn, "calibrate_btn_theme")

            dpg.add_separator()
            dpg.add_spacer(height=10)

            with dpg.group(horizontal=True):
                # --- Measurement History (left column)
                with dpg.group():
                    dpg.add_text("Measurement History:", color=(100, 200, 255))
                    dpg.add_spacer(height=5)
                    with dpg.child_window(width=420, height=360, tag="meas_scroll"):
                        dpg.add_group(tag="meas_container")

                dpg.add_spacer(width=30)

                # --- Session info (center column, width=288)
                with dpg.group(width=288):
                    dpg.add_text("Session Info:", color=(100, 200, 255))
                    dpg.add_spacer(height=5)
                    new_session_btn = dpg.add_button(
                        label="New Session", width=288, height=30
                    )
                    dpg.add_spacer(height=5)

                    with dpg.popup(
                        new_session_btn,
                        mousebutton=dpg.mvMouseButton_Left,
                        modal=True,
                        tag="new_session_popup",
                    ):
                        dpg.add_text(
                            "Enter session name (max 31 chars, allowed: a-z, A-Z, 0-9, space, _, -)"
                        )
                        dpg.add_text(
                            "File will be created: <session_name>_YYYYMMDD_HHMMSS.csv"
                        )
                        dpg.add_spacer(height=5)
                        dpg.add_input_text(
                            tag="session_name_input",
                            default_value=self.session_name,
                            width=360,
                            on_enter=True,
                            callback=self._confirm_new_session,
                            user_data=(serial_handler, csv_handler),
                        )
                        dpg.add_spacer(height=8)
                        with dpg.group(horizontal=True):
                            dpg.add_button(
                                label="Create",
                                callback=self._confirm_new_session,
                                width=120,
                                height=30,
                                user_data=(serial_handler, csv_handler),
                            )
                            dpg.add_button(
                                label="Cancel",
                                callback=lambda: dpg.configure_item(
                                    "new_session_popup", show=False
                                ),
                                width=120,
                                height=30,
                            )

                    with dpg.group(horizontal=True):
                        dpg.add_text("Session:")
                        csv_link_btn = dpg.add_button(
                            label="(none)",
                            tag="csv_info",
                            callback=self._open_csv_directory,
                            user_data=csv_handler,
                            small=True,
                        )
                    with dpg.tooltip("csv_info"):
                        dpg.add_text("(none)", tag="csv_info_tooltip")
                    if not dpg.does_item_exist("csv_link_theme"):
                        with dpg.theme(tag="csv_link_theme"):
                            with dpg.theme_component(dpg.mvButton):
                                dpg.add_theme_color(dpg.mvThemeCol_Text, (100, 180, 255, 255))
                                dpg.add_theme_color(dpg.mvThemeCol_Button, (0, 0, 0, 0))
                                dpg.add_theme_color(dpg.mvThemeCol_ButtonHovered, (0, 0, 0, 0))
                                dpg.add_theme_color(dpg.mvThemeCol_ButtonActive, (0, 0, 0, 0))
                    dpg.bind_item_theme(csv_link_btn, "csv_link_theme")

                    dpg.add_spacer(height=15)
                    dpg.add_checkbox(
                        label="Include timestamp",
                        callback=self._timestamp_checkbox,
                        tag="timestamp_cb",
                        default_value=True,
                    )
                    dpg.add_checkbox(
                        label="Include angle",
                        callback=self._angle_checkbox,
                        tag="angle_cb",
                        default_value=True,
                    )

                dpg.add_spacer(width=30)

                # --- Measurement controls (right column, width=288)
                with dpg.group(width=288):
                    dpg.add_text("Measurement Controls:", color=(100, 200, 255))
                    dpg.add_spacer(height=5)
                    measure_btn = dpg.add_button(
                        label="Measure (m)",
                        callback=self._trigger,
                        width=288,
                        height=55,
                        user_data=serial_handler,
                    )

                    if not dpg.does_item_exist("measure_button_theme"):
                        with dpg.theme(tag="measure_button_theme"):
                            with dpg.theme_component(dpg.mvButton):
                                dpg.add_theme_color(
                                    dpg.mvThemeCol_Text, (0, 200, 0, 255)
                                )

                    dpg.bind_item_theme(measure_btn, "measure_button_theme")

                    if dpg.does_item_exist("font_bold"):
                        dpg.bind_item_font(measure_btn, "font_bold")

                    dpg.add_spacer(height=5)
                    dpg.add_button(
                        label="Cancel last measurement",
                        callback=self._cancel_last_measurement,
                        width=288,
                        height=30,
                    )

            dpg.add_spacer(height=10)

            # Live Plot
            with dpg.plot(label="Measurements", height=-1, width=-1, tag="measurement_plot"):
                dpg.add_plot_legend()
                dpg.add_plot_axis(dpg.mvXAxis, label="Measurement #", tag="x_axis")
                dpg.add_plot_axis(dpg.mvYAxis, label="Value", tag="y_axis")
                dpg.add_line_series(
                    [], [], label="Measurement", parent="y_axis", tag="plot_data"
                )

    def _open_csv_directory(self, sender, app_data, user_data):
        """Open the directory containing the current CSV file in file manager."""
        csv_handler = user_data
        filename = None
        try:
            if csv_handler is not None and hasattr(csv_handler, "get_filename"):
                filename = csv_handler.get_filename()
        except Exception:
            filename = None

        if not filename:
            return

        abs_path = os.path.abspath(filename)
        directory = os.path.dirname(abs_path)

        try:
            # Hide the console window of the spawned helper process on Windows.
            creationflags = getattr(subprocess, "CREATE_NO_WINDOW", 0)
            if sys.platform.startswith("win"):
                subprocess.Popen(["explorer", "/select,", abs_path], creationflags=creationflags)
            elif sys.platform.startswith("darwin"):
                subprocess.Popen(["open", "-R", abs_path])
            else:
                subprocess.Popen(["xdg-open", directory])
        except Exception:
            pass

    @staticmethod
    def align_toolbar() -> None:
        """Push Calibration label + button to the right edge of the toolbar."""
        MeasurementTab._align_row_spacer("meas_toolbar_row", "meas_toolbar_spacer")

    @staticmethod
    def _align_row_spacer(row_tag: str, spacer_tag: str) -> None:
        """Push elements after `spacer_tag` to the right edge of `row_tag`."""
        try:
            if not dpg.does_item_exist(spacer_tag):
                return
            if not dpg.does_item_exist(row_tag):
                return

            try:
                avail_w = int(dpg.get_viewport_client_width()) - 32
            except Exception:
                avail_w = 1100
            if avail_w <= 0:
                avail_w = 1100

            try:
                children = dpg.get_item_children(row_tag, 1) or []
            except Exception:
                children = []

            spacer_index = None
            for idx, child in enumerate(children):
                try:
                    if dpg.get_item_alias(child) == spacer_tag:
                        spacer_index = idx
                        break
                except Exception:
                    pass
            if spacer_index is None:
                return

            left_w = 0
            for child in children[:spacer_index]:
                try:
                    w = dpg.get_item_rect_size(child)[0]
                    left_w += int(w)
                except Exception:
                    pass
            right_w = 0
            for child in children[spacer_index + 1 :]:
                try:
                    w = dpg.get_item_rect_size(child)[0]
                    right_w += int(w)
                except Exception:
                    pass

            ITEM_SPACING = 8
            num_gaps = max(len(children) - 1, 0)
            gaps_w = num_gaps * ITEM_SPACING

            spacer_w = avail_w - left_w - right_w - gaps_w
            if spacer_w < 10:
                spacer_w = 10

            dpg.configure_item(spacer_tag, width=spacer_w)
        except Exception:
            pass

    @staticmethod
    def _set_csv_info_label(filename: str | None) -> None:
        """Set csv_info button label to full filename.

        Session name is limited to 31 characters when creating a new session,
        so the full filename fits in the status row without truncation.
        """
        display = filename if filename else "(none)"
        try:
            if dpg.does_item_exist("csv_info"):
                dpg.configure_item("csv_info", label=display)
            if dpg.does_item_exist("csv_info_tooltip"):
                dpg.set_value("csv_info_tooltip", display)
        except Exception:
            pass

    @staticmethod
    def set_connection_status(status: str | None) -> None:
        """Update the connection status shown in the window title bar.

        Args:
            status: connection text (e.g. "Connected to COM7"), or None when
                    not connected (falls back to the plain app title).
        """
        try:
            if status:
                dpg.set_viewport_title(f"{_APP_TITLE} - {status}")
            else:
                dpg.set_viewport_title(_APP_TITLE)
        except Exception:
            pass

    def _trigger(self, sender, app_data, user_data):
        """Send trigger command"""
        serial_handler = user_data
        serial_handler.write("m")

    def _on_calibrate_btn(self, sender, app_data, user_data):
        """Toolbar 'Calibration' button: invoke the on_calibrate callback
        (same action as Settings 'Get raw value')."""
        if callable(self._on_calibrate):
            try:
                self._on_calibrate()
            except Exception:
                pass

    def set_calibrate_enabled(self, enabled: bool) -> None:
        """Enable or disable the toolbar 'Calibrate' button."""
        try:
            if dpg.does_item_exist("calibrate_btn"):
                dpg.configure_item("calibrate_btn", enabled=enabled)
        except Exception:
            pass

    def _on_ref_input_changed(self, sender, app_data, user_data):
        """Invoke on_reference_changed when the user edits the Reference field."""
        if callable(self._on_reference_changed):
            try:
                self._on_reference_changed(app_data)
            except Exception:
                pass

    def _cancel_last_measurement(self, sender=None, app_data=None, user_data=None):
        """Cancel last measurement: remove from history/chart, rewrite CSV, refresh Gauge."""
        self.drop_last_measurement()

        # Gauge tab sync (e.g. show previous measurement or clear)
        if callable(self._on_drop):
            try:
                self._on_drop()
            except Exception:
                pass

    def _clear(self, sender=None, app_data=None, user_data=None):
        """Clear all measurements (local GUI state only)."""
        self.meas_history.clear()
        self.plot_x.clear()
        self.plot_y.clear()
        self.measurement_count = 0
        dpg.set_value("plot_data", [list(self.plot_x), list(self.plot_y)])
        self._show_measurements()

    def _confirm_new_session(self, sender, app_data, user_data):
        """Create new CSV file with session name as prefix and clear history."""
        serial_handler, csv_handler = user_data

        # Read session name
        try:
            session_name = str(dpg.get_value("session_name_input")).strip()
        except Exception:
            session_name = ""

        # Session name validation
        if not self._validate_session_name(session_name):
            return

        self.session_name = session_name

        # Sending command 'n' to ESP32 Master
        try:
            if (
                serial_handler is not None
                and hasattr(serial_handler, "is_open")
                and serial_handler.is_open()
            ):
                serial_handler.write(f"n {session_name}")
                # Sending reference after creating new session
                try:
                    ref_val = float(dpg.get_value("ref_input_meas"))
                    ref_val = self._clamp_float(ref_val, -999.999, 999.999)
                    dpg.set_value("ref_input_meas", ref_val)
                    serial_handler.write(f"v {ref_val:.3f}")
                except Exception:
                    pass
                # Save to application log (via callback in main)
            else:
                return
        except Exception:
            return

        # Use session name as CSV file prefix
        self.csv_prefix = session_name

        # Clear GUI measurements
        self._clear()

        # Create CSV file now
        filename = None
        try:
            filename = csv_handler.create_new_file(
                prefix=self.csv_prefix,
                include_timestamp=self.include_timestamp,
                include_angle=self.include_angle,
                calibration_offset=self.calibration_offset,
                reference=self.reference,
            )
        except Exception:
            filename = None

        if filename:
            self._set_csv_info_label(os.path.basename(filename))

        # Calibrate button is disabled until the Reference field is edited again.
        self.set_calibrate_enabled(False)

        try:
            dpg.configure_item("new_session_popup", show=False)
        except Exception:
            pass

    @staticmethod
    def _clamp_float(val: float, vmin: float, vmax: float) -> float:
        return max(vmin, min(vmax, float(val)))

    @staticmethod
    def _validate_session_name(name: str) -> bool:
        """Session name validation.

        Args:
            name: Session name to validate

        Returns:
            True if name is valid
        """
        # Minimum length: 1 character
        if not name or len(name) < 1:
            return False

        # Maximum length: 31 characters
        if len(name) > 31:
            return False

        # Allowed characters: letters (a-z, A-Z), digits (0-9), spaces, underscores (_), hyphens (-)
        allowed_pattern = r"^[a-zA-Z0-9 _-]+$"
        if not re.match(allowed_pattern, name):
            return False

        return True

    def _timestamp_checkbox(self, sender, app_data, user_data):
        """Toggle timestamp inclusion"""
        self.include_timestamp = app_data
        self._show_measurements()

    def _angle_checkbox(self, sender, app_data, user_data):
        """Toggle angle inclusion"""
        self.include_angle = app_data
        self._show_measurements()

    def _save_csv_from_history(self):
        """Rewrite the open CSV file from the current measurement history.

        Called whenever the history list changes (add/drop) so the file on disk
        always reflects the GUI list. No-op when no session CSV is open.
        """
        if self._csv_handler is None or not self._csv_handler.is_open():
            return
        try:
            self._csv_handler.rewrite(
                list(self.meas_history),
                self.calibration_offset,
                self.reference,
                self.include_timestamp,
                self.include_angle,
            )
        except Exception:
            pass

    def add_measurement(
        self, timestamp: str, value: str, numeric_value: float, angle: str = ""
    ):
        """Add a measurement to history and plot

        Args:
            timestamp: Timestamp string
            value: Measurement value string
            numeric_value: Numeric value for plotting
            angle: Angle string (optional)
        """
        self.meas_history.append((timestamp, value, angle))
        self.measurement_count += 1

        # Update plot
        self.plot_x.append(self.measurement_count)
        self.plot_y.append(numeric_value)

        # Update GUI
        dpg.set_value("plot_data", [list(self.plot_x), list(self.plot_y)])
        self._update_plot_axes()
        self._show_measurements()

        # Persist full CSV from current history list
        self._save_csv_from_history()

    def drop_last_measurement(self):
        """Remove the most recent measurement from history and plot"""
        if not self.meas_history:
            return False

        self.meas_history.pop()
        if self.plot_x:
            self.plot_x.pop()
        if self.plot_y:
            self.plot_y.pop()
        if self.measurement_count > 0:
            self.measurement_count -= 1

        dpg.set_value("plot_data", [list(self.plot_x), list(self.plot_y)])
        self._update_plot_axes()
        self._show_measurements()

        # Persist full CSV from current history list
        self._save_csv_from_history()
        return True

    def _show_measurements(self):
        """Display measurements in the history view"""
        if dpg.does_item_exist("meas_container"):
            dpg.delete_item("meas_container", children_only=True)

        columns = ["Index", "Value"]
        if self.include_angle:
            columns.append("Angle")
        if self.include_timestamp:
            columns.append("Timestamp")
        dpg.add_text("  ".join(columns), color=(180, 180, 180), parent="meas_container")

        recent_measurements = list(self.meas_history)[-200:]
        start_idx = max(1, len(self.meas_history) - len(recent_measurements) + 1)

        for idx, (t, v, a) in enumerate(recent_measurements, start=start_idx):
            parts = [v]  # Always show measurement first
            if self.include_angle:
                parts.append(a)
            if self.include_timestamp:
                parts.append(t)
            line = f"{idx}: {' '.join(parts)}"
            dpg.add_text(line, parent="meas_container")

        if len(self.meas_history) > 0:

            def _autoscroll():
                try:
                    if dpg.does_item_exist("meas_scroll"):
                        dpg.set_y_scroll(
                            "meas_scroll", dpg.get_y_scroll_max("meas_scroll")
                        )
                except Exception:
                    pass

            threading.Timer(0.05, _autoscroll).start()

    def _update_plot_axes(self):
        """Update plot axis limits"""
        if len(self.plot_y) == 0:
            return

        y_min = min(self.plot_y)
        y_max = max(self.plot_y)
        y_range = y_max - y_min

        if y_range < 0.001:
            margin = 0.1
        else:
            margin = y_range * 0.1

        dpg.set_axis_limits("y_axis", y_min - margin, y_max + margin)

        if len(self.plot_x) > 0:
            dpg.set_axis_limits(
                "x_axis", min(self.plot_x) - 0.5, max(self.plot_x) + 0.5
            )
