ciupakt/caliper/(commit log)

2025-11-10 added hw solution
    [esp32_slave.kicad_pcb, esp32_slave.kicad_sch]
2025-11-11 Added motor driver
2025-11-11 Cleanup project.
    [measurement_20251111_011027.csv]
2025-11-11 New motor driver
2025-11-11 update caliper slave motor control implementation
2025-11-11 Update motor control system
    [esp32_slave.kicad_sch]
2025-11-29 Update motor driver
2025-11-30 Omtimise motor driver.
2025-11-30 Fixed 1.
    [esp32_slave.kicad_pcb, esp32_slave.kicad_sch, measurement_20251130_233225.csv]
2026-08-08 the calibration offset will be subtracted
2026-08-09 rearange buttons
2026-08-09 rework calibration feature
2026-08-09 rework calibration on web side
    [main.cpp]
2026-08-09 fixed problem with cliper data
    [caliper.cpp, caliper.h, main.cpp]
2026-08-10 trip pin after interrupt attachment
2026-08-10 fixed led gpio
